LeaderXinjianSun/X758No2-PLC/微信图片_20170820083238.jpg

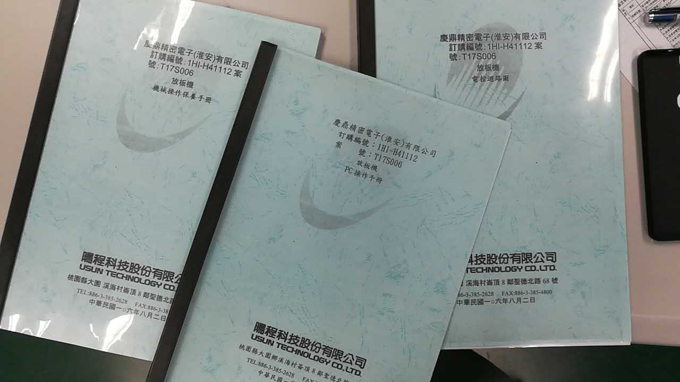
微信图片_20170820083238.jpg
