LeaderXinjianSun/X758No2-PLC/X758样本程序设计.docx

1. SamPickfromPanel 从样本盘取料
  a) 点位SampleP1、SampleP2、SampleP3、SampleP4和SamplePass1、SamplePass2
  b) 条件： 有需求（存在空穴）、爪手A、B都空
  c) 等待条件：→提示需要往样本盘添加产品
    i. 全空穴
  d) 备注：NGItems(PASS、NG1、NG2和NG3)在产品盘各占一个位置，最多4个
2. 爪手逻辑
  a) 有料
    i. 有需求→放料
    ii. 无需求→样本盘对应位置空→放回
    iii. 无需求→样本盘对应位置满→放入NG盘
  b) 无料
    i. 有需求→全空穴→退出。会在SamPickfromPanel函数里等待
    ii. 有需求→存在满穴→等测完，取出。但接收样本盘对应项目（有需求）有料打断
    iii. 无需求→存在满穴→等测完，取出
    iv. 无需求→全空穴→退出。会触发样本测试结束
3. Ngitems

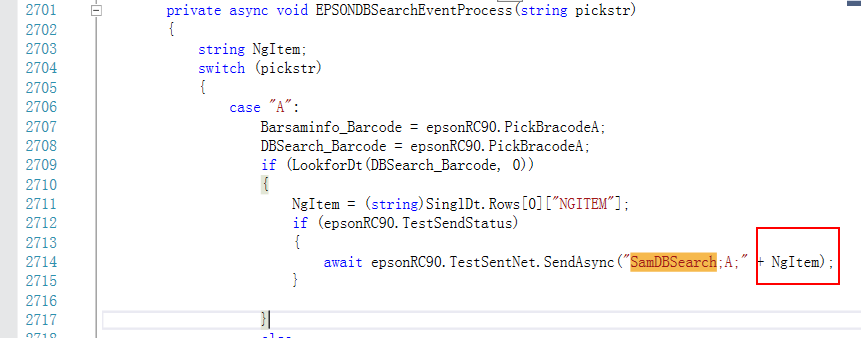
[picture p2: figure]
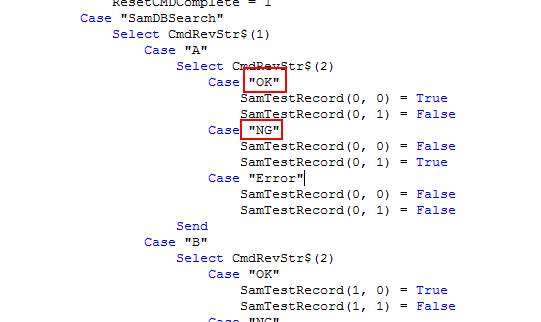
[picture p3: figure]
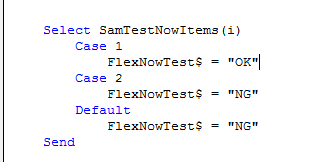
[picture p4: figure]
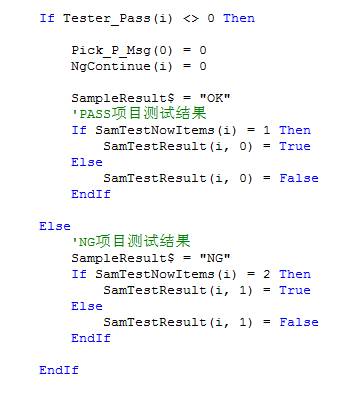
[picture p5: figure]

4. 待问询
  a) 何时有样本？
    i. 力德尔软体录入功能被取消，无法自行录入。
  b) 力德尔软体和上传软件通讯方式可否更改为网络通信？
    i. 采用UDP通讯
    ii. 此方式已在深圳Senser上料机实现
    iii. 客户计划的通信方式（DDE），
