LeaderXinjianSun/X758No2-PLC/力德尔技术手册封面.docx

# 鹏鼎控股(淮安)有限公司

## 订单编号：1HI-H31043

## 案号：T17S012

## 自动上料机

## 电控回路图

# 江苏力德尔电子信息技术有限公司

## JiangSu Leader Electronic Information Technology Co.，LTd

## 南通经济技术开发区新东路9号

## TEL: 86-513-65060557 FAX: 0513-65060559

## 二〇一七年六月二日
