LeaderXinjianSun/X758No2-PLC/X758GRR程序设计.docx

1. 从料盘取料
  a) 条件：
    i. A、B都空
    ii. 存在空穴
    iii. Pcs数不够
2. 爪手逻辑
  a) 有料：
    i. 测满→下料
    ii. 未侧满，空穴、目标穴→放料
  b) 无料
    i. 下一爪手有料，且存在空穴（打断）
    ii. 等测完，另外一只爪手有料，且当前穴是目标穴 或 当前穴次数未到
    iii. 等测完，另外一只爪手无料
      1. 拎
      2. 测试数未到→放（复测）
      3. 测试数到→不放
3. 下料逻辑
  a) 有料
    i. 测试次数到→下料
4. 测完判断
  a) 数量够、爪手无料、测试机全空
5. 初始有料
  a) 提示，要求清空
