LeaderXinjianSun/X758No2-PLC/X758资料.xlsx

Sheet: 设计规划
燕麦测试机线路归纳
测试机 | 3孔电源 |  |  | DB25接口
 | 2孔电源
 | 2孔电源
工控电脑 | 3孔电源 | 外网接口 | 内网接口
Mac电脑 | 2孔电源 | 外网接口 | 内网接口

Sheet: 采购20170210
序号 | 部件 | 型号 | 品牌 | 数量 | 备注 | 链接
1 | 开关面板 | 118型十孔 | 公牛 | 4 |  | https://detail.tmall.com/item.htm?id=19462920730&scene=taobao_shop
2 | 开关面板 | 118型十五孔 | 公牛 | 4 |  | https://detail.tmall.com/item.htm?id=15712582277&rn=fc19248c7d7d37fd1f3f4dd1f73d6402&abbucket=3
3 | 开关面板暗盒 | 118型十孔暗盒 | 公牛 | 4 |  | https://detail.tmall.com/item.htm?id=19464136209&scene=taobao_shop
4 | 开关面板暗盒 | 118型十五孔暗盒 | 公牛 | 4 |  | https://detail.tmall.com/item.htm?id=15716013019&scene=taobao_shop
5 | 4网口面板86型 | S2026C | 松日 | 4 |  | https://detail.tmall.com/item.htm?id=7596926201&ali_trackid=1_7183dcb1adca24f587821240ccff6bc4
6 | 松日86型暗盒 | 620105 | 松日 | 4 |  | https://detail.tmall.com/item.htm?_u=af5j4l7969a&id=7540695185
7 | 电脑主机 | 9020MT | 戴尔 | 1 |  | https://item.taobao.com/item.htm?spm=a1z10.1-c.w4004-1195050327.16.7s5mRP&id=45575396463
8 | PCI-E网卡 | EXPI9301C | Intel | 1 |  | https://item.jd.com/1529606972.html

Sheet: IO表
测试机抓放本体IO表(机械手)-RC90
序号 | 输入端子 | 线标 |  |  | 输出端子 | 线标 | 输出信号
1 | Input No.0 | IN0 | 负压表A |  | Output No.0 | OUT0 | 吸头A真空吸
2 | Input No.1 | IN1 | 负压表B |  | Output No.1 | OUT1 | 吸头A破真空
3 | Input No.2 | IN2 | 旋转气缸SET |  | Output No.2 | OUT2 | 吸头B真空吸
4 | Input No.3 | IN3 | 旋转气缸RST |  | Output No.3 | OUT3 | 吸头B破真空
5 | Input No.4 | IN4 | 测试机A-左 后到位信号 |  | Output No.4 | OUT4 | 旋转气缸
6 | Input No.5 | IN5 | 测试机A-右 后到位信号 |  | Output No.5 | OUT5 | 矫正气缸，上料
7 | Input No.6 | IN6 | 测试机A-左 上到位信号 |  | Output No.6 | OUT6 | 锤子气缸
8 | Input No.7 | IN7 | 测试机A-右 上到位信号 |  | Output No.7 | OUT7 | BR对位信号
9 | Input No.8 | IN8 | DangerIn |  | Output No.8 | OUT8 | 测试机A-左启动真空吸
10 | Input No.9 | IN9 | FeedReady |  | Output No.9 | OUT9 | 测试机A-右启动真空吸
11 | Input No.10 | IN10 | 测试机A-左穴1 真空吸状态信号 |  | Output No.10 | OUT10 | 测试机B-左启动真空吸
12 | Input No.11 | IN11 | 测试机A-左穴2 真空吸状态信号 |  | Output No.11 | OUT11 | 测试机B-右启动真空吸
13 | Input No.12 | IN12 | 测试机A-右穴1 真空吸状态信号 |  | Output No.12 | OUT12 | 吸头A上下气缸
14 | Input No.13 | IN13 | 测试机A-右穴2 真空吸状态信号 |  | Output No.13 | OUT13 | 吸头B上下气缸
15 | Input No.14 | IN14 | 测试机B-左 后到位信号 |  | Output No.14 | OUT14 | DangerOut
16 | Input No.15 | IN15 | 测试机B-右 后到位信号 |  | Output No.15 | OUT15 | FeedEmpty
17 | Input No.16 | IN16 | 测试机B-左 上到位信号
18 | Input No.17 | IN17 | 测试机B-右 上到位信号
19 | Input No.18 | IN18
20 | Input No.19 | IN19
21 | Input No.20 | IN20 | 测试机B- 左穴1 真空吸状态信号
22 | Input No.21 | IN21 | 测试机B-左穴2 真空吸状态信号
23 | Input No.22 | IN22 | 测试机B-右穴1 真空吸状态信号
24 | Input No.23 | IN23 | 测试机B -右穴2 真空吸状态信号
信捷PLC
序号 | 输入端子 | 线标 |  |  | 输出端子 | 线标 | 输出信号
1 | X0 | X0 | 安全门1 |  | Y0 | Y0 | 上料1电机脉冲 | XD5-60T6
2 | X1 | X1 | 安全门2 |  | Y1 | Y1 | 上料2电机脉冲
3 | X2 | X2 | 安全门3 |  | Y2 | Y2 | 下料1电机脉冲
4 | X3 | X3 | 安全门4 |  | Y3 | Y3 | 下料2电机脉冲
5 | X4 | X4 | 安全门5 |  | Y4 | Y4 | AL对位信号
6 | X5 | X5 | 安全门6 |  | Y5 | Y5 | AR对位信号
7 | X6 | X6 | 安全门7 |  | Y6 | Y6 | 上料1电机方向
8 | X7 | X7 | 安全门8 |  | Y7 | Y7 | 上料2电机方向
9 | X10 | X10 | 安全门9 |  | Y10 | Y10 | 下料1电机方向
10 | X11 | X11 | 安全门10 |  | Y11 | Y11 | 下料2电机方向
11 | X12 | X12 | 安全门11 |  | Y12 | Y12 | 屏蔽安全门
12 | X13 | X13 | 安全门12 |  | Y13 | Y13 | BL对位信号
13 | X14 | X14 | 急停按钮 |  | Y14 | Y14 | 三色灯-红
14 | X15 | X15 | 上料1模组上光电开关【常闭】 |  | Y15 | Y15 | 三色灯-黄
15 | X16 | X16 | 上料1模组下光电开关【常闭】 |  | Y16 | Y16 | 三色灯-绿
16 | X17 | X17 | 上料2模组上光电开关【常闭】 |  | Y17 | Y17 | 三色灯-蜂鸣器
17 | X20 | X20 | 上料2模组下光电开关【常闭】 |  | Y20 | Y20 | 无杆气缸，上料，产品
18 | X21 | X21 | 下料1模组上光电开关【常闭】 |  | Y21 | Y21 | 无杆气缸，上料，空盘
19 | X22 | X22 | 下料1模组下光电开关【常闭】 |  | Y22 | Y22 | 上下气缸，上料，产品
20 | X23 | X23 | 下料2模组上光电开关【常闭】 |  | Y23 | Y23 | 上下气缸，上料，空盘
21 | X24 | X24 | 下料2模组下光电开关【常闭】 |  | Y24 | Y24 | 真空吸，上料，空盘
22 | X25 | X25 | 按钮，上料电机1点动+ |  | Y25 | Y25 | DangerIn
23 | X26 | X26 | 按钮，上料电机1点动- |  | Y26 | Y26 | 真空吸1，上料，产品
24 | X27 | X27 | 按钮，上料电机1复位 |  | Y27 | Y27 | 真空吸2，上料，产品
25 | X30 | X30 | 按钮，上料电机2点动+
26 | X31 | X31 | 按钮，上料电机2点动-
27 | X32 | X32 | 按钮，上料电机2复位
28 | X33 | X33 | 无杆气缸，上料，产品，SET
29 | X34 | X34 | 料盘到位光纤，上料，产品盘2
30 | X35 | X35 | 无杆气缸，上料，产品，RST
31 | X36 | X36 | 无杆气缸，上料，空盘，SET
32 | X37 | X37 | 料盘到位光纤，上料，空盘2
33 | X40 | X40 | 无杆气缸，上料，空盘，RST
34 | X41 | X41 | 上下气缸，上料，产品，SET
35 | X42 | X42 | 上下气缸，上料，产品，RST
36 | X43 | X43 | 上下气缸，上料，空盘，SET
37 | X10000 | X10000 | 上下气缸，上料，空盘，RST |  | Y10000 | Y10000 | 真空吸3，上料，产品 | XD-E8X8YT
38 | X10001 | X10001 | 真空吸，上料，空盘，负压表 |  | Y10001 | Y10001 | 真空吸4，上料，产品
39 | X10002 | X10002 | 真空吸1，上料，产品，负压表 |  | Y10002 | Y10002 | 真空吸5，上料，产品
40 | X10003 | X10003 | 真空吸2，上料，产品，负压表 |  | Y10003 | Y10003 | 真空吸6，上料，产品
41 | X10004 | X10004 | 真空吸3，上料，产品，负压表 |  | Y10004 | Y10004 | 无杆气缸，下料，空盘
42 | X10005 | X10005 | 真空吸4，上料，产品，负压表 |  | Y10005 | Y10005 | 上下气缸，下料，空盘
43 | X10006 | X10006 | 真空吸5，上料，产品，负压表 |  | Y10006 | Y10006 | 真空吸，下料，空盘
44 | X10007 | X10007 | 真空吸6，上料，产品，负压表 |  | Y10007 | Y10007 | FeedReady
45 | X10100 | X10100 | 料盘有无光电开关，上料，产品盘 |  |  |  |  | XD-E16X
46 | X10101 | X10101 | 料盘有无光电开关，上料，空盘
47 | X10102 | X10102 | 料盘到位光纤，上料，产品盘
48 | X10103 | X10103 | 料盘到位光纤，上料，空盘
49 | X10104 | X10104 | 无杆气缸，下料，空盘，SET
50 | X10105 | X10105
51 | X10106 | X10106 | 无杆气缸，下料，空盘，RST
52 | X10107 | X10107 | 上下气缸，下料，空盘，SET
53 | X10110 | X10110 | 上下气缸，下料，空盘，RST
54 | X10111 | X10111 | 真空吸，下料，空盘，负压表
55 | X10112 | X10112 | 料盘有无光电开关，下料，产品盘
56 | X10113 | X10113 | 料盘有无光电开关，下料，空盘
57 | X10114 | X10114 | 料盘到位光纤，下料，产品盘
58 | X10115 | X10115 | 料盘到位光纤，下料，空盘
59 | X10116 | X10116 | 料盘到位光纤，下料，产品盘2
60 | X10117 | X10117 | 料盘到位光纤，下料，空盘2
61 | X10200 | X10200 | 按钮，下料电机1点动+ |  |  |  |  | XD-E16X
62 | X10201 | X10201 | 按钮，下料电机1点动-
63 | X10202 | X10202 | 按钮，下料电机1复位
64 | X10203 | X10203 | 按钮，下料电机2点动+
65 | X10204 | X10204 | 按钮，下料电机2点动-
66 | X10205 | X10205 | 按钮，下料电机2复位
67 | X10206 | X10206 | DangerOut
68 | X10207 | X10207 | FeedEmpty
69 | X10210 | X10210 | 上料吸盘光纤1
70 | X10211 | X10211 | 上料吸盘光纤2
71 | X10212 | X10212 | 下料吸盘光纤1
72 | X10213 | X10213 | 下料吸盘光纤2
73 | X10214 | X10214 | 无杆气缸，上料，空盘，MID
74 | X10215 | X10215
75 | X10216 | X10216
76 | X10217 | X10217
倍福PLC
序号 | 输入端子 | 线标 | 输入信号 | EL1889 | 输出端子 | 线标 | 输出信号 | EL2889
1 | Input No.1 | BFI1 | 机械手底座模组，原点 |  | Output No.1 | BFO1 | 上下气缸，下料，产品
2 | Input No.2 | BFI2 | 运料模组，原点 |  | Output No.2 | BFO2 | 真空吸，下料，产品
3 | Input No.3 | BFI3 | 下料X轴模组，原点 |  | Output No.3 | BFO3 | 真空吸，运料
4 | Input No.4 | BFI4 | 下料Y轴模组，原点 |  | Output No.4 | BFO4
5 | Input No.5 | BFI5 | 上下气缸，下料，产品，SET |  | Output No.5 | BFO5
6 | Input No.6 | BFI6 | 上下气缸，下料，产品，RST |  | Output No.6 | BFO6
7 | Input No.7 | BFI7 | 负压表，下料，产品 |  | Output No.7 | BFO7
8 | Input No.8 | BFI8 | 急停信号 |  | Output No.8 | BFO8
9 | Input No.9 | BFI9 | 安全门信号 |  | Output No.9 | BFO9
10 | Input No.10 | BFI10 |  |  | Output No.10 | BFO10
11 | Input No.11 | BFI11 |  |  | Output No.11 | BFO11
12 | Input No.12 | BFI12 |  |  | Output No.12 | BFO12
13 | Input No.13 | BFI13 |  |  | Output No.13 | BFO13
14 | Input No.14 | BFI14 |  |  | Output No.14 | BFO14
15 | Input No.15 | BFI15 |  |  | Output No.15 | BFO15
16 | Input No.16 | BFI16 |  |  | Output No.16 | BFO16

Sheet: 机柜布局
序号 | 部件 | 数量 | 宽度
1 | 8路继电器板 | 3 | 133
2 | 继电器 | 15 | 23
3 | 48V电源 | 1 | 110
4 | 24V电源 | 2 | 40
5 | 空开 | 6 | 35.4
6 | 漏电保护开关 | 1 | 63
7 | 单相滤波器 | 1 | 57.5 | https://item.taobao.com/item.htm?spm=a230r.1.14.1.siy64S&id=521259984914&ns=1&abbucket=15#detail
8 | DB25端子台 | 3 | 90
9 | DB50端子台 | 1 | 110
10 | 信捷60点PLC | 1 | 177.2
11 | 信捷8入8出模块 | 1 | 63
12 | 信捷16入模块 | 1 | 63
13 | 倍福 | 1 | 40
14 | 接地条 | 2
15 | 步进驱动器 | 4 |  | https://item.taobao.com/item.htm?id=39468895435&spm=2014.21600712.0.0
16 | 750W伺服驱动器 | 1
17 | 200W伺服驱动器 | 1
18 | 100W伺服驱动器 | 1
19 | 4连开关面板 | 1 |  | https://detail.tmall.com/item.htm?id=15712630333&rn=7c4cb6b3a5564bf28e34f05d51bb2908&abbucket=3
20 | 电脑 | 1
21 | 机械手控制器 | 1
22 | 7连大电磁阀 | 1
23 | 3连大电磁阀 | 1

Sheet: 物料清单 采购格式 (2)
 |  |  |  |  |  |  |  |  |  | 文件编号： | LDR-SJ-0220
物料清单（电气）: |  |  |  |  |  |  |  |  |  | 编号：
项目名称： |  | X758 FCT冶具自動上下料机 |  |  | 设计工程师： | 孙鑫建 |  |  | 制 单 时 间： |  | 20170323
客 户： |  | 臻鼎科技（淮安） |  |  | 领 料 人： |  |  |  | 装 配 时 间：
数 量： |  |  |  |  | 主 管 签 字： |  |  |  | 经 理 签 字：
序号 | 物料编号 | 物料名称 |  | 型号 |  | 品牌 | 数量 | 单位 | 单价 | 采购件 | 链接
1 |  | 控制 | 电脑主机 | 9020MT |  | 戴尔 | 1 | 台 |  | √ | https://item.taobao.com/item.htm?spm=a1z10.1-c.w4004-1195050327.16.7s5mRP&id=45575396463
2 |  |  | PCI-E网卡 | EXPI9301C |  | Intel | 1 | 个 |  | √
3 |  |  | PCI网卡 | TG-3269C |  | TP-LINK | 1 | 块
4 |  |  | PLC 主机 | XD5-60T4 |  | 信捷 | 1 | 个 |  | √
5 |  |  | PLC IO扩展 | XD-E8X8YT |  | 信捷 | 1 | 个 |  | √
6 |  |  | PLC IO扩展 | XD-E16X |  | 信捷 | 2 | 个 |  | √
7 |  |  | PLC 串口扩展 | XD-NE-BD |  | 信捷 | 1 | 个 |  | √
8 |  |  | PLC 耦合模块 | EK1100 |  | 倍福 | 1 | 个
9 |  |  | PLC 输入模块 | EL1889 |  | 倍福 | 1 | 个
10 |  |  | PLC 输出模块 | EL2889 |  | 倍福 | 1 | 个
11 |  |  | 交换机 | SF90D-16 |  | 思科 | 2 | 个 |  | √
12 |  |  | 触摸屏 | TH765-MT(P)/UT(P) |  | 信捷 | 1 | 个
13 |  |  | PLC数据线 | DVP 3m |  |  | 2 | 根
14 |  |  | 网线 | 2m |  |  | 3 | 根 |  | √
15 |  |  | 网线 | 0.5m |  |  | 3 | 根 |  | √
16 |  |  | 鼠标 | OP-520 |  | 双飞燕 | 1 | 个 |  | √
17 |  |  | 键盘 | KL-5 |  | 双飞燕 | 1 | 个 |  | √
18 |  |  | 扫码器 | SR700 |  | 基恩士 | 1 | 个 |  | √
19 |  |  | 显示器 | E1715S |  | 戴尔 | 1 | 个 |  | √
20 |  |  | 视频分割器 |  |  |  | 1 | 个 |  | √
21 |  |  | USB延长线 公对公 | 6m |  |  | 4 | 根 |  |  | https://detail.tmall.com/item.htm?id=18475491585&cm_id=140105335569ed55e27b&abbucket=15&skuId=3187969819168
22 |  |  | USB转RJ45网线接口 | 绿联20254 |  | 绿联 | 3 | 个 |  | √
23 |  |  | USB转485串口线 | UT-890 |  | 宇态 | 1 | 根
24 |  |  | 相机 | MER-500-14GM |  | 大恒相机 | 1 | 个 |  | √
25 |  |  | 镜头 | M0814-MP2 |  | Computar | 1 | 个 |  | √
26 |  | 电机 | 伺服电机 | ECMA-C20807RS |  | 台达 | 1 | 个 |  | √
27 |  |  | 伺服驱动器 | ASD-A2-0721-E |  | 台达 | 1 | 个 |  | √
28 |  |  | 伺服电机 | ECMA-C20602RS |  | 台达 | 2 | 个 |  | √
29 |  |  | 伺服驱动器 | ASD-A2-0221-E |  | 台达 | 2 | 个 |  | √
30 |  |  | 伺服电机 | ECMA-C20401ES |  | 台达 | 1 | 个 |  | √
31 |  |  | 伺服驱动器 | ASD-A2-0121-E |  | 台达 | 1 | 个 |  | √
32 |  |  | 电机动力线 | HVPS04AA03MB |  | 台达 | 4 | 根 |  | √
33 |  |  | 电机编码器线 | HVE13IAB03MB |  | 台达 | 4 | 根 |  | √
34 |  |  | 机械手 | LS3-401S |  | EPSON | 1 | 台 |  | √
35 |  |  | 机器人控制器 | RC90 |  | EPSON | 1 | 台 |  | √
36 |  |  | 步进电机 | 86HSZ12N |  | 普菲德 | 4 | 个 |  | √ | https://item.taobao.com/item.htm?id=39468895435&spm=2014.21600712.0.0
37 |  |  | 步进电机驱动器 | HBS86H |  | 普菲德 | 4 | 个 |  | √
38 |  | 电源 | 空气开关 | DZ47s-2P D10 |  | 德力西 | 6 | 个
39 |  |  | 漏电保护开关 | DZ47sLE C32 |  | 德力西 | 1 | 个
40 |  |  | 手柄+负荷开关 | VCF1C+V1C（32A） |  | 施耐德 | 1 | 个 |  | √
41 |  |  | 单相滤波器 | SJD430D-30A |  | 上海赛纪 | 1 | 个 |  | √
42 |  | 机柜 | 三色灯 | XVG-B3SM |  | 施耐德 | 1 | 个
43 |  |  | 风扇 | DLF1224LB |  |  | 6 | 个
44 |  |  | 按钮 | XB5AA31C NO |  | 施耐德 | 8 | 个
45 |  |  | 按钮 | XB5AA51C NO |  | 施耐德 | 4 | 个
46 |  |  | 急停按钮 | XB5AS542C 1NC |  | 施耐德 | 4 | 个
47 |  |  | 急停按钮黄色标牌 |  |  |  | 4 | 个
48 |  |  | 急停按钮保护罩 |  |  |  | 4 | 个
49 |  |  | 电源指示灯 | XB7EVM3LC |  | 施耐德 | 1 | 个
50 |  |  | 防暴LED灯 |  |  |  | 2 | 个
51 |  |  | 离子风机 | 545×430×69 |  |  | 3 | 个 |  | √
52 |  |  | 门开关 | FM18-08N |  |  | 12 | 个
53 |  |  | 继电器 | MY2N-GS |  |  | 15 | 个
54 |  |  | 环形变压器 | 400W 输入220V 输出50V |  | 普菲德 | 2 | 个 |  | √ | https://item.taobao.com/item.htm?id=40701634110&idnum=0
55 |  |  | 开关电源 | NDR-120-24 120W |  | 铭纬 | 2 | 个
56 |  |  | 传感器(方缸) | DS1-J |  | SMC | 4 | 个
57 |  |  | 传感器（无杆气缸） | GL-8H |  | SMC | 6 | 个
58 |  |  | 传感器（旋转气缸） | DMSH-020 |  | SMC | 2 | 个
59 |  |  | 传感器（下料上下） | CS1G020 |  | SMC | 2 | 个
60 |  |  | 光纤传感器 | FU-35 |  | 基恩士 | 8 | 个
61 |  |  | 光纤放大器 | FS-V21R |  | 基恩士 | 8 | 个
62 |  |  | 光电传感器 | E3ZG-D61 |  | 欧姆龙 | 4 | 个 |  | √
63 |  |  | 光电开关 | LU672-5NA |  | HUAYIFENG | 8 | 个 |  | √ | http://www.hyfcn.com/caoxingguangdianchuanganqi/40-30.html
64 |  |  | 转接板 | ST081N |  |  | 8 | 个
65 |  |  | DB50端子台 | 孔座 |  |  | 1 | 个 |  | √
66 |  |  | DB25端子台 | 孔座 |  |  | 1 | 个 |  | √
67 |  |  | DB50连接线 | 公对母3米 |  |  | 1 | 个 |  | √
68 |  |  | DB25连接线 | 公对母3米 |  |  | 1 | 个 |  | √
69 |  |  | DB25连接线 | 公对母8米 |  |  | 2 | 个 |  | √ | https://detail.tmall.com/item.htm?id=37296774762&cm_id=140105335569ed55e27b&abbucket=15&skuId=3244136704421
70 |  |  | DB9交叉线 | 母对母2米 |  |  | 1 | 个 |  | √
71 |  |  | DB25端子台 | 针座 |  |  | 2 | 个 |  | √
72 |  |  | 继电器板 | 8路/24V，低电平触发 |  | 欧姆龙 | 3 | 个 |  | √
73 |  |  | 开关面板 | 118型十孔 |  | 公牛 | 2 | 个 |  | √
74 |  |  | 开关面板 | 118型十五孔 |  | 公牛 | 3 | 个 |  | √
75 |  |  | 开关面板 | 118型二十孔 |  | 公牛 | 1 | 个 |  | √
76 |  |  | 开关面板暗盒 | 118型十孔暗盒 |  | 公牛 | 2 | 个 |  | √
77 |  |  | 开关面板暗盒 | 118型十五孔暗盒 |  | 公牛 | 2 | 个 |  | √
78 |  |  | 开关面板暗盒 | 118型二十孔暗盒 |  | 公牛 | 1 | 个 |  | √
79 |  |  | 开关面板86型 | 5孔 |  | 公牛 | 3 | 个 |  | √ | https://detail.tmall.com/item.htm?id=12602398346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
80 |  |  | 开关面板明盒86型 | 5孔明盒 |  | 公牛 | 3 | 个 |  | √ | https://detail.tmall.com/item.htm?spm=a1z10.3.w17-1900164721.12.x53eDv&id=7213752271
81 |  |  | 4网口面板86型 | S2026C |  | 松日 | 1 | 个 |  | √ | https://detail.tmall.com/item.htm?id=7596926201&ali_trackid=1_7183dcb1adca24f587821240ccff6bc4
82 |  |  | 松日86型暗盒 | 620105 |  | 松日 | 1 | 个 |  | √ | https://detail.tmall.com/item.htm?_u=af5j4l7969a&id=7540695185
83 |  |  | 静电插座 |  |  | 思米高 | 4 | 个 |  | √ | https://item.taobao.com/item.htm?spm=a230r.1.14.20.DcQKot&id=22969060230&ns=1&abbucket=15#detail
84 |  | 气动 | 电磁阀 | 4V210-08 7联 |  |  | 1 | 个
85 |  |  | 电磁阀 | 4V210-08 3联 |  |  | 1 | 个
86 |  |  | 电磁阀 | SY3120 6联 |  |  | 1 | 个
87 |  |  | 电磁阀 | SY3120 单个 |  |  | 5 | 个
88 |  |  | 多功能真空发生器 | ZK2A07K5KW-06 |  | SMC | 2 | 个
89 |  |  | 负压表 | DP-101 |  | 松下 | 9 | 个
90 |  | 装配 | 电源线 | 5m |  |  | 2 | 根
91 |  |  | 电源线 | 2m |  |  | 2 | 根
92 |  |  | VGA线 | 3m |  |  | 2 | 根 |  | √
93 |  |  | VGA线 | 6m |  |  | 4 | 根 |  | √ | https://detail.tmall.com/item.htm?id=44867041912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
94 |  |  | 接地柱 |  |  |  | 1 | 个
95 |  |  | 接地排 |  |  |  | 1 | 个
96 |  |  | 2.5mm 导线（黑色） |  |  |  |  | 米
97 |  |  | 2.5mm 导线 （蓝色） |  |  |  |  | 米
98 |  |  | 2.5mm 导线 （黄绿） |  |  |  |  | 米
99 |  |  | 1 mm 导线 （红色） |  |  |  |  | 米
100 |  |  | 1 mm 导线 （白色） |  |  |  |  | 米
101 |  |  | 0.5mm 导线 （黑色） |  |  |  |  | 米
102 |  |  | 多芯线 10芯 |  |  |  |  | 米
103 |  |  | 捷固端子 |  |  |  |  | 个
104 |  |  | 接地端子 |  |  |  |  | 个
105 |  |  | U型线鼻子 |  |  |  |  | 个
106 |  |  | 空中接头 |  |  |  |  | 个
107 |  |  | O型线鼻子 |  |  |  |  | 个
108 |  |  | 马鞍型固定座 |  |  |  |  | 个
109 |  |  | 导轨 |  |  |  |  | 米
110 |  |  | 线槽 |  |  |  |  | 米
111 |  |  | 插头 |  |  |  | 1 | 个

Sheet: 线束规划
电源线 | PC | 1
 | 显示器 | 2
 | 测试机 | 2
测试机 | 电源线 | 1
 | 网线 | 4
 | 地线 | 1
 | DB25 | 1
电源插头 | 交换机 | 2
 | 切屏器 | 1

Sheet: 多芯线
 | 序号 | 颜色 | 信号 | 信息
1 | 1 | 红 | 24V
 | 2 | 黑 | X25 | 按钮，上料电机1点动+
 | 3 | 棕 | X26 | 按钮，上料电机1点动-
 | 4 | 橙 | X27 | 按钮，上料电机1复位
 | 5 | 黄 | X30 | 按钮，上料电机2点动+
 | 6 | 绿 | X31 | 按钮，上料电机2点动-
 | 7 | 兰 | X32 | 按钮，上料电机2复位
 | 8 | 紫
 | 9 | 灰
 | 10 | 白 | 0V
 | 序号 | 颜色 | 信号 | 信息
2 | 1 | 红 | 24V
 | 2 | 黑 | X10200 | 按钮，下料电机1点动+
 | 3 | 棕 | X10201 | 按钮，下料电机1点动-
 | 4 | 橙 | X10202 | 按钮，下料电机1复位
 | 5 | 黄 | X10203 | 按钮，下料电机2点动+
 | 6 | 绿 | X10204 | 按钮，下料电机2点动-
 | 7 | 兰 | X10205 | 按钮，下料电机2复位
 | 8 | 紫
 | 9 | 灰
 | 10 | 白 | 0V
 | 序号 | 颜色 | 信号 | 信息
3 | 1 | 红 | 24V
 | 2 | 黑 | X15 | 上料1模组上光电开关
 | 3 | 棕 | X16 | 上料1模组下光电开关
 | 4 | 橙 | X10100 | 料盘有无光电开关，上料，产品盘
 | 5 | 黄 | X10102 | 料盘到位光纤，上料，产品盘
 | 6 | 绿 | X33 | 无杆气缸，上料，产品，SET
 | 7 | 兰 | X34 | 无杆气缸，上料，产品，MID
 | 8 | 紫 | X35 | 无杆气缸，上料，产品，RST
 | 9 | 灰
 | 10 | 白 | 0V
 | 序号 | 颜色 | 信号 | 信息
4 | 1 | 红 | 24V
 | 2 | 黑 | X0 | 安全门1
 | 3 | 棕 | X1 | 安全门2
 | 4 | 橙 | X2 | 安全门3
 | 5 | 黄 | X41 | 上下气缸，上料，产品，SET
 | 6 | 绿 | X42 | 上下气缸，上料，产品，RST
 | 7 | 兰
 | 8 | 紫
 | 9 | 灰
 | 10 | 白 | 0V
 | 序号 | 颜色 | 信号 | 信息
5 | 1 | 红 | 24V
 | 2 | 黑 | X17 | 上料2模组上光电开关
 | 3 | 棕 | X20 | 上料2模组下光电开关
 | 4 | 橙 | X10101 | 料盘有无光电开关，上料，空盘
 | 5 | 黄 | X10103 | 料盘到位光纤，上料，空盘
 | 6 | 绿 | X36 | 无杆气缸，上料，空盘，SET
 | 7 | 兰 | X37 | 无杆气缸，上料，空盘，MID
 | 8 | 紫 | X40 | 无杆气缸，上料，空盘，RST
 | 9 | 灰 | X10001 | 真空吸，上料，空盘，负压表
 | 10 | 白 | 0V
 | 序号 | 颜色 | 信号 | 信息
6 | 1 | 红 | 24V
 | 2 | 黑 | X3 | 安全门4
 | 3 | 棕 | X4 | 安全门5
 | 4 | 橙 | X5 | 安全门6
 | 5 | 黄 | X43 | 上下气缸，上料，空盘，SET
 | 6 | 绿 | X10000 | 上下气缸，上料，空盘，RST
 | 7 | 兰 | BFI2 | 运料模组，原点
 | 8 | 紫 | IN2 | 旋转气缸SET
 | 9 | 灰 | IN3 | 旋转气缸RST
 | 10 | 白 | 0V
 | 序号 | 颜色 | 信号 | 信息
7 | 1 | 红 | 24V
 | 2 | 黑 | X21 | 下料1模组上光电开关
 | 3 | 棕 | X22 | 下料1模组下光电开关
 | 4 | 橙 | X10112 | 料盘有无光电开关，下料，产品盘
 | 5 | 黄 | X10114 | 料盘到位光纤，下料，产品盘
 | 6 | 绿 | BFI5 | 上下气缸，下料，产品，SET
 | 7 | 兰 | BFI6 | 上下气缸，下料，产品，RST
 | 8 | 紫 | BFI3 | 下料X轴模组，原点
 | 9 | 灰 | BFI4 | 下料Y轴模组，原点
 | 10 | 白 | 0V
 | 序号 | 颜色 | 信号 | 信息
8 | 1 | 红 | 24V
 | 2 | 黑 | X11 | 安全门10
 | 3 | 棕 | X12 | 安全门11
 | 4 | 橙 | X13 | 安全门12
 | 5 | 黄 | BFI7 | 负压表，下料，产品
 | 6 | 绿 | BFO1 | 上下气缸，下料，产品
 | 7 | 兰 | BFO2 | 真空吸，下料，产品
 | 8 | 紫
 | 9 | 灰
 | 10 | 白 | 0V
 | 序号 | 颜色 | 信号 | 信息
9 | 1 | 红 | 24V
 | 2 | 黑 | X10104 | 无杆气缸，下料，空盘，SET
 | 3 | 棕 | X10105 | 无杆气缸，下料，空盘，MID
 | 4 | 橙 | X10106 | 无杆气缸，下料，空盘，RST
 | 5 | 黄 | X10107 | 上下气缸，下料，空盘，SET
 | 6 | 绿 | X10110 | 上下气缸，下料，空盘，RST
 | 7 | 兰 | X10111 | 真空吸，下料，空盘，负压表
 | 8 | 紫
 | 9 | 灰
 | 10 | 白 | 0V
 | 序号 | 颜色 | 信号 | 信息
10 | 1 | 红 | 24V
 | 2 | 黑 | X6 | 安全门7
 | 3 | 棕 | X7 | 安全门8
 | 4 | 橙 | X10 | 安全门9
 | 5 | 黄 | X17 | 上料2模组上光电开关
 | 6 | 绿 | X20 | 上料2模组下光电开关
 | 7 | 兰 | X10113 | 料盘有无光电开关，下料，空盘
 | 8 | 紫 | X10115 | 料盘到位光纤，下料，空盘
 | 9 | 灰
 | 10 | 白 | 0V
 | 序号 | 颜色 | 信号 | 信息
11 | 1 | 红 | 24V
 | 2 | 黑 | Y26 | 真空吸1，上料，产品
 | 3 | 棕 | Y27 | 真空吸2，上料，产品
 | 4 | 橙 | Y10000 | 真空吸3，上料，产品
 | 5 | 黄 | Y10001 | 真空吸4，上料，产品
 | 6 | 绿 | Y10002 | 真空吸5，上料，产品
 | 7 | 兰 | Y10003 | 真空吸6，上料，产品
 | 8 | 紫
 | 9 | 灰
 | 10 | 白 | 0V
 | 序号 | 颜色 | 信号 | 信息
12 | 1 | 红 | 24V
 | 2 | 黑 | X10002 | 真空吸1，上料，产品，负压表
 | 3 | 棕 | X10003 | 真空吸2，上料，产品，负压表
 | 4 | 橙 | X10004 | 真空吸3，上料，产品，负压表
 | 5 | 黄 | X10005 | 真空吸4，上料，产品，负压表
 | 6 | 绿 | X10006 | 真空吸5，上料，产品，负压表
 | 7 | 兰 | X10007 | 真空吸6，上料，产品，负压表
 | 8 | 紫
 | 9 | 灰
 | 10 | 白 | 0V
 | 序号 | 颜色 | 信号 | 信息
13 | 1 | 棕
 | 2 | 红 | A+
 | 3 | 品红 | A-
 | 4 | 黄 | B+
 | 5 | 绿 | B-
 | 6 | 兰
 | 序号 | 颜色 | 信号 | 信息
14 | 1 | 棕
 | 2 | 红 | A+
 | 3 | 品红 | A-
 | 4 | 黄 | B+
 | 5 | 绿 | B-
 | 6 | 兰
 | 序号 | 颜色 | 信号 | 信息
15 | 1 | 棕
 | 2 | 红 | A+
 | 3 | 品红 | A-
 | 4 | 黄 | B+
 | 5 | 绿 | B-
 | 6 | 兰
 | 序号 | 颜色 | 信号 | 信息
16 | 1 | 棕
 | 2 | 红 | A+
 | 3 | 品红 | A-
 | 4 | 黄 | B+
 | 5 | 绿 | B-
 | 6 | 兰
 | 序号 | 颜色 | 信号 | 信息
17 | 1 | 红 | 24V |  | 蓝1
 | 2 | 黑 | IN0 | 负压表A | 蓝2
 | 3 | 棕 | IN1 | 负压表B | 蓝3
 | 4 | 橙 | OUT0 | 吸头A真空吸 | 蓝4
 | 5 | 黄 | OUT1 | 吸头A破真空 | 蓝5
 | 6 | 绿 | OUT2 | 吸头B真空吸 | 棕1
 | 7 | 兰 | OUT3 | 吸头B破真空 | 棕2
 | 8 | 紫 | OUT12 | 吸头A上下气缸 | 棕3
 | 9 | 灰 | OUT13 | 吸头B上下气缸 | 棕4
 | 10 | 白 | 0V |  | 棕5
 | 序号 | 颜色
 | 1 | 红
 | 2 | 黑
 | 3 | 棕
 | 4 | 橙
 | 5 | 黄
 | 6 | 绿
 | 7 | 兰
 | 8 | 紫
 | 9 | 灰
 | 10 | 白

Sheet: DB端子台
 | 类型 | 板信息 | 序号 | 线标 | 功能 |  | 类型 | 板信息 | 序号 | 线标 | 功能 |  | 类型 | 板信息 | 序号 | 线标 | 功能
① | DB25 孔座 | 机械手安全回路 | 1 | ESW11 | 紧急停止SW1接点 | ③ | DB25 针座 | 燕麦测试机A | 1 | YM24V1 | 燕麦24V | ④ | DB25 针座 | 燕麦测试机B | 1 | YM24V2 | 燕麦24V
 |  |  | 2 | ESW12 | 紧急停止SW1接点 |  |  |  | 2 | ALUp | 左-天板上到位識別信號 |  |  |  | 2 | BLUp | 左-天板上到位識別信號
 |  |  | 3 | ESTOP1+ | 紧急停止通路1+ |  |  |  | 3 | ALRear | 左-天板后到位識別信號 |  |  |  | 3 | BLRear | 左-天板后到位識別信號
 |  |  | 4 | ESTOP1- | 紧急停止通路1- |  |  |  | 4 | ALRecify | 左-开始对位信号 |  |  |  | 4 | BLRecify | 左-开始对位信号
 |  |  | 5 |  |  |  |  |  | 5 | ARRecify | 右-开始对位信号 |  |  |  | 5 | BRRecify | 右-开始对位信号
 |  |  | 6 |  |  |  |  |  | 6 |  |  |  |  |  | 6
 |  |  | 7 | SD11 | 安全门输入1+ |  |  |  | 7 | ARUp | 右-天板上到位識別信號 |  |  |  | 7 | BRUp | 右-天板上到位識別信號
 |  |  | 8 | SD23 | 安全门输入1- |  |  |  | 8 | ARRear | 右-天板后到位識別信號 |  |  |  | 8 | BRRear | 右-天板后到位識別信號
 |  |  | 9 | C24V | RC90 24V输出 |  |  |  | 9 |  |  |  |  |  | 9
 |  |  | 10 | C24V | RC90 24V输出 |  |  |  | 10 |  |  |  |  |  | 10
 |  |  | 11 | C0V | RC90 24VGND输出 |  |  |  | 11 |  |  |  |  |  | 11
 |  |  | 12 | C0V | RC90 24VGND输出 |  |  |  | 12 |  |  |  |  |  | 12
 |  |  | 13 |  |  |  |  |  | 13 | ALSuck | 左-載板啟動真空吸 |  |  |  | 13 | BLSuck | 左-載板啟動真空吸
 |  |  | 14 | ESW21 | 紧急停止SW2接点 |  |  |  | 14 | ARSuck | 右-載板啟動真空吸 |  |  |  | 14 | BRSuck | 右-載板啟動真空吸
 |  |  | 15 | ESW22 | 紧急停止SW2接点 |  |  |  | 15 | ALPass | 左-PASS信號 |  |  |  | 15 | BLPass | 左-PASS信號
 |  |  | 16 | ESTOP2+ | 紧急停止通路2+ |  |  |  | 16 | ARPass | 右-PASS信號 |  |  |  | 16 | BRPass | 右-PASS信號
 |  |  | 17 | ESTOP2- | 紧急停止通路2- |  |  |  | 17 | ALVoccum1 | 左側穴1真空吸狀態信號 |  |  |  | 17 | BLVoccum1 | 左側穴1真空吸狀態信號
 |  |  | 18 | SDLATCH1 | 安全门闩锁解除 |  |  |  | 18 | ALVoccum2 | 左側穴2真空吸狀態信號 |  |  |  | 18 | BLVoccum2 | 左側穴2真空吸狀態信號
 |  |  | 19 | SDLATCH2 | 安全门闩锁解除 |  |  |  | 19 | ARVoccum1 | 右側穴1真空吸狀態信號 |  |  |  | 19 | BRVoccum1 | 右側穴1真空吸狀態信號
 |  |  | 20 | SD21 | 安全门输入2+ |  |  |  | 20 | ARVoccum2 | 右側穴2真空吸狀態信號 |  |  |  | 20 | BRVoccum2 | 右側穴2真空吸狀態信號
 |  |  | 21 | SD22 | 安全门输入2- |  |  |  | 21 | ALRun | 左-測試運行中 |  |  |  | 21 | BLRun | 左-測試運行中
 |  |  | 22 |  |  |  |  |  | 22 | ARRun | 右-測試運行中 |  |  |  | 22 | BRRun | 右-測試運行中
 |  |  | 23 |  |  |  |  |  | 23 |  |  |  |  |  | 23
 |  |  | 24 |  |  |  |  |  | 24 |  |  |  |  |  | 24
 |  |  | 25 |  |  |  |  |  | 25 | YM0V1 | 燕麦24VGND |  |  |  | 25 | YM0V2 | 燕麦24VGND
 | 类型 | 板信息 | 序号 | 线标 | 功能
② | DB50 孔座 | 机械手IO | 1 | COM | 输入公共端子No.0~7
 |  |  | 2 | IN0 | 输入No.0
 |  |  | 3 | IN1 | 输入No.1
 |  |  | 4 | IN2 | 输入No.2
 |  |  | 5 | IN3 | 输入No.3
 |  |  | 6 | IN4 | 输入No.4
 |  |  | 7 | IN5 | 输入No.5
 |  |  | 8 | IN6 | 输入No.6
 |  |  | 9 | IN7 | 输入No.7
 |  |  | 10 | OUT0 | 输出No.0
 |  |  | 11 | OUT1 | 输出No.1
 |  |  | 12 | OUT2 | 输出No.2
 |  |  | 13 | OUT3 | 输出No.3
 |  |  | 14 | OUT4 | 输出No.4
 |  |  | 15 | OUT5 | 输出No.5
 |  |  | 16
 |  |  | 17 | COM0 | 输出公共端子No.0~7
 |  |  | 18 | COM | 输入公共端子No.8~15
 |  |  | 19 | IN8 | 输入No.8
 |  |  | 20 | IN9 | 输入No.9
 |  |  | 21 | IN10 | 输入No.10
 |  |  | 22 | IN11 | 输入No.11
 |  |  | 23 | IN12 | 输入No.12
 |  |  | 24 | IN13 | 输入No.13
 |  |  | 25 | IN14 | 输入No.14
 |  |  | 26 | IN15 | 输入No.15
 |  |  | 27 | OUT6 | 输出No.6
 |  |  | 28 | OUT7 | 输出No.7
 |  |  | 29 | OUT8 | 输出No.8
 |  |  | 30 | OUT9 | 输出No.9
 |  |  | 31 | OUT10 | 输出No.10
 |  |  | 32
 |  |  | 33 | COM1 | 输出公共端子No.8~15
 |  |  | 34 | COM | 输入公共端子No.16~23
 |  |  | 35 | IN16 | 输入No.16
 |  |  | 36 | IN17 | 输入No.17
 |  |  | 37 | IN18 | 输入No.18
 |  |  | 38 | IN19 | 输入No.19
 |  |  | 39 | IN20 | 输入No.20
 |  |  | 40 | IN21 | 输入No.21
 |  |  | 41 | IN22 | 输入No.22
 |  |  | 42 | IN23 | 输入No.23
 |  |  | 43 | OUT11 | 输出No.11
 |  |  | 44 | OUT12 | 输出No.12
 |  |  | 45 | OUT13 | 输出No.13
 |  |  | 46 | OUT14 | 输出No.14
 |  |  | 47 | OUT15 | 输出No.15
 |  |  | 48
 |  |  | 49
 |  |  | 50

Sheet: 编程规划
 | 起始 | 结束
电机驱动 | M0 | M24 | 上料轴1
 | D0 | D24
 | HD0 | HD24
 | M25 | M49 | 上料轴2
 | D25 | D49
 | HD25 | HD49
 | M50 | M74 | 下料轴1
 | D50 | D74
 | HD50 | HD74
 | M75 | M99 | 下料轴2
 | D75 | D99
 | HD75 | HD99
全局监控 | M100 | M124
复位 | M125 | M174
标志位 | M175 | M199
逻辑步1 | M200 | M299
上料轴1 | M300 | M349
上料轴2 | M350 | M399
上位机通信 | M400 | M499
等待上料轴1，动作结束 | M500 | M524
等待上料轴2，动作结束 | M525 | M549
逻辑步1 | M600 | M699
上料轴1 | M700 | M749
上料轴2 | M750 | M799
等待下料轴1，动作结束 | M800 | M824
等待下料轴2，动作结束 | M825 | M849
调试2 | M850 | M899
逻辑步2 | M900 | M999
复位2 | M1000 | M1049
与机械手通信【读】 | D1000 | D1003
与机械手通信【写】 | D1006 | D1009
 | M1200 | M1299
 |  |  |  |  |  | 上料，轴1 | 上料，轴2
 |  |  |  | 动作 | 条件
 |  |  |  | 往上 |  | Up传感器/判断有无光电开关→降到底，报警（料盘空）→等待条件满足+“复位”
 |  |  |  |  | 光纤传感器【到】
 |  |  |  | 往下 |  |  | Down传感器→报警（空盘满）→等待条件满足+“复位”
 |  |  |  |  | 光纤传感器【无】

Sheet: 电机参数
步进电机 | 导程 | 5 | mm
 | 编码器分辨率 | 5000 | pls/rev
 | 齿轮比 | 1
 | 最高频率 | 50 | KHz
伺服电机 | 导程 | 16 | mm
 | 编码器分辨率 | 10000 | pls/rev
 | 刻度 | 0.0016
 | 最高速度 | 800 | mm/s
伺服电机 | 导程 | 20 | mm
 | 编码器分辨率 | 10000 | pls/rev
 | 刻度 | 0.002
 | 最高速度 | 1000 | mm/s

Sheet: 随机配送清单
X758随机配送清单 |  | 日期 | 20170308
序号 | 内容 | 数量 | 单位
1 | 电脑主机 | 1 | 台
2 | 显示器 | 1 | 个
3 | 鼠标 | 1 | 个
4 | 键盘 | 1 | 个
5 | 键盘支架 | 2 | 个
6 | 网线 | 2 | 根
7 | 急停按钮 | 4 | 套
8 | 静电环装置 | 4 | 个
9 | 机械手控制器 | 1 | 台
10 | USB延长线 | 1 | 根

Sheet: 调试计划
X758 NO.2 调试计划
序号 | 内容 | 时间
1 | 轴、气缸驱动程序验证 |  | 2017-03-10
2 | 机械手程序验证 | 2017-03-11 | 2017-03-12
3 | 上位机程序验证 | 2017-03-13 | 2017-03-14

Sheet: 补物料
部件 | 规格 | 数量 | 单位
USB延长线 | 公对公6米 | 4 | 根
DB25连接线 | 公对母8米 | 2 | 个
DB9交叉线 | 母对母2米 | 1 | 个
VGA线 | 6米 | 4 | 根
纽扣电池 | CR2032 | 1 | 个

Sheet: 机械手PLC通信
 | 机械手输入 | PLC |  | 机械手输出
1 | 512 | M2000 | DangerIn | 512 | M2100 | DangerOut
2 | 513 | M2001 |  | 513 | M2101
3 | 514 | M2002 |  | 514 | M2102 | FeedEmpty
4 | 515 | M2003 |  | 515 | M2103
5 | 516 | M2004 |  | 516 | M2104 | 旋转气缸SET
6 | 517 | M2005 |  | 517 | M2105 | 旋转气缸RST
7 | 518 | M2006 |  | 518 | M2106
8 | 519 | M2007 |  | 519 | M2107
9 | 520 | M2008 |  | 520 | M2108 | Discharing
10 | 521 | M2009 |  | 521 | M2109
11 | 522 | M2010 | CloseCMD | 522 | M2110 | PrePickCMD
12 | 523 | M2011 | AutoDischarge | 523 | M2111
13 | 524 | M2012 | FeedReady | 524 | M2112
14 | 525 | M2013 |  | 525 | M2113 | WaitPCS
15 | 526 | M2014 |  | 526 | M2114
16 | 527 | M2015 |  | 527 | M2115
17 | 528 | M2016 |  | 528 | M2116 | 暂停
18 | 529 | M2017 |  | 529 | M2117 | 运行
19 | 530 | M2018 |  | 530 | M2118
20 | 531 | M2019 |  | 531 | M2119
21 | 532 | M2020 |  | 532 | M2120
22 | 533 | M2021 |  | 533 | M2121
23 | 534 | M2022 |  | 534 | M2122
24 | 535 | M2023 | PreFill1 | 535 | M2123 | AL对位信号
25 | 536 | M2024 | PreFill2 | 536 | M2124 | AR对位信号
26 | 537 | M2025 | PreFill3 | 537 | M2125 | BL对位信号
27 | 538 | M2026 | PreFill4 | 538 | M2126
28 | 539 | M2027 | PreFill5 | 539 | M2127
29 | 540 | M2028 | PreFill6 | 540 | M2128
30 | 541 | M2029 |  | 541 | M2129
31 | 542 | M2030 |  | 542 | M2130 | Alarm_SuckFail
32 | 543 | M2031 |  | 543 | M2131 | Alarm_ReleaseFail
33 | 544 | M2032 |  | 544 | M2132
34 | 545 | M2033 |  | 545 | M2133
35 | 546 | M2034 |  | 546 | M2134
36 | 547 | M2035 |  | 547 | M2135
37 | 548 | M2036 |  | 548 | M2136
38 | 549 | M2037 |  | 549 | M2137
39 | 550 | M2038 |  | 550 | M2138
40 | 551 | M2039 |  | 551 | M2139
41 | 552 | M2040 |  | 552 | M2140
42 | 553 | M2041 |  | 553 | M2141
43 | 554 | M2042 |  | 554 | M2142
44 | 555 | M2043 |  | 555 | M2143
45 | 556 | M2044 |  | 556 | M2144
46 | 557 | M2045 |  | 557 | M2145
47 | 558 | M2046 |  | 558 | M2146
48 | 559 | M2047 |  | 559 | M2147
49 | 560 | M2048 |  | 560 | M2148
50 | 561 | M2049 |  | 561 | M2149
51 | 562 | M2050 |  | 562 | M2150
52 | 563 | M2051 |  | 563 | M2151
53 | 564 | M2052 |  | 564 | M2152
54 | 565 | M2053 |  | 565 | M2153
55 | 566 | M2054 |  | 566 | M2154
56 | 567 | M2055 |  | 567 | M2155
57 | 568 | M2056 |  | 568 | M2156
58 | 569 | M2057 |  | 569 | M2157
59 | 570 | M2058 |  | 570 | M2158
60 | 571 | M2059 |  | 571 | M2159
61 | 572 | M2060 |  | 572 | M2160
62 | 573 | M2061 |  | 573 | M2161
63 | 574 | M2062 |  | 574 | M2162
64 | 575 | M2063 |  | 575 | M2163

Sheet: 机械手命令
 |  | 底座位
取料位 | 进 | 上料盘 | pass ScanPositionP3L;go APickFeed1
 | 出 |  | pass ScanPositionP3L ;go ChangeHandL
治具穴1位 | 进 | 穴1 | PASS A1PASS1;PASS A1PASS2;PASS B_1 +z(5);GO A_1
 | 出 |  | PASS B_1 +z(5);PASS A1PASS2;PASS A1PASS1;GO ChangeHandL
治具穴2位 | 进 | 穴2 | PASS A2PASS1;PASS A2PASS2;PASS B_2 +z(5);GO A_2 +z(2.5)
 | 出 |  | PASS B_2;PASS A2PASS2;PASS A2PASS1;GO ChangeHandL
治具穴3位 | 进 | 穴3 | PASS A3PASS1;PASS A3PASS2;PASS B_3 +z(5);GO A_3
 | 出 |  | PASS B_3 +z(5);PASS A3PASS2;PASS A3PASS1;GO ChangeHandL
治具穴4位 | 进 | 穴4 | PASS A4PASS1;PASS A4PASS2;PASS A4PASS3;PASS A4PASS4;PASS B_4 + z(5);GO A_4
 | 出 |  | pass b_4 +z(5);PASS A4PASS4;PASS A4PASS3;PASS A4PASS2;PASS A4PASS1;GO ChangeHandL
NG位 | 进 | NG盘 | pass NCuip1;pass NCuip2;pass NCuip3;go NCui_1
 | 出 |  | pass NCuip3;pass NCuip2;pass NCuip1;go ChangeHandL
样本盘 | 进 | 样本盘 | pass SamplePass1;pass SamplePass2;go SampleP1_A
 | 出 |  | pass SamplePass2;pass SamplePass1;go ChangeHandL

Sheet: 机械手点位说明
点 | 标签 | 底座 | 机械手姿势 | 说明
P7 | ScanPositionP3L | 上料位 | Left | 扫码坐标
P8 | ScanPositionP3L_B | 上料位 | Left | 扫码坐标B爪
P11 | APickFeed1 | 上料位 | Left | 矫正盘吸取位1
P12 | APickFeed2 | 上料位 | Left | 矫正盘吸取位2
P13 | APickFeed3 | 上料位 | Left | 矫正盘吸取位3
P14 | APickFeed4 | 上料位 | Left | 矫正盘吸取位4
P15 | APickFeed5 | 上料位 | Left | 矫正盘吸取位5
P16 | APickFeed6 | 上料位 | Left | 矫正盘吸取位6
P30 | TPosition1 | 穴1 | Left | B爪放下料小车位1
P31 | TPosition2 | 穴2 | Left | B爪放下料小车位2
P32 | TPosition3 | 穴3 | Left | B爪放下料小车位3
P33 | TPosition4 | 穴4 | Left | B爪放下料小车位4
P34 | TPosition1_A | 穴1 | Left | A爪放下料小车位1
P35 | TPosition2_A | 穴2 | Left | A爪放下料小车位2
P36 | TPosition3_A | 穴3 | Left | A爪放下料小车位3
P37 | TPosition4_A | 穴4 | Left | A爪放下料小车位4
P38 | TPosition5 | 上料位 | Left | B爪放下料小车位5
P39 | TPosition5_A | 上料位 | Left | A爪放下料小车位5
P41 | A_1 | 穴1 | Left | A爪测试机内取放产品位1
P42 | A_2 | 穴2 | Left | A爪测试机内取放产品位2
P43 | A_3 | 穴3 | Left | A爪测试机内取放产品位3
P44 | A_4 | 穴4 | Left | A爪测试机内取放产品位4
P51 | B_1 | 穴1 | Left | B爪测试机内取放产品位1
P52 | B_2 | 穴2 | Left | B爪测试机内取放产品位2
P53 | B_3 | 穴3 | Left | B爪测试机内取放产品位3
P54 | B_4 | 穴4 | Left | B爪测试机内取放产品位4
P80 | ChangeHandL |  | Left | 机械手收缩姿势
P120 | SampleP1 | 样本盘 | Left | B爪手样本盘点1
P121 | SampleP2 | 样本盘 | Left | B爪手样本盘点2
P122 | SampleP3 | 样本盘 | Left | B爪手样本盘点3
P123 | SampleP4 | 样本盘 | Left | B爪手样本盘点4
P124 | SampleP5 | 样本盘 | Left | B爪手样本盘点5
P125 | SampleP6 | 样本盘 | Left | B爪手样本盘点6
P126 | SampleP7 | 样本盘 | Left | B爪手样本盘点7
P127 | SampleP8 | 样本盘 | Left | B爪手样本盘点8
P128 | SampleP1_A | 样本盘 | Left | A爪手样本盘点1
P129 | SampleP2_A | 样本盘 | Left | A爪手样本盘点2
P130 | SampleP3_A | 样本盘 | Left | A爪手样本盘点3
P131 | SampleP4_A | 样本盘 | Left | A爪手样本盘点4
P132 | SampleP5_A | 样本盘 | Left | A爪手样本盘点5
P133 | SampleP6_A | 样本盘 | Left | A爪手样本盘点6
P134 | SampleP7_A | 样本盘 | Left | A爪手样本盘点7
P135 | SampleP8_A | 样本盘 | Left | A爪手样本盘点8
P140 | SamplePass1 | 样本盘 | Left | 去样本盘经过点1
P141 | SamplePass2 | 样本盘 | Left | 去样本盘经过点2
P220 | A1PASS1 | 穴1 | Left | 去穴1经过点1
P221 | A1PASS2 | 穴1 | Left | 去穴1经过点2
P230 | A2PASS1 | 穴2 | Left | 去穴2经过点1
P231 | A2PASS2 | 穴2 | Left | 去穴2经过点2
P240 | A3PASS1 | 穴3 | Left | 去穴3经过点1
P241 | A3PASS2 | 穴3 | Left | 去穴3经过点2
P250 | A4PASS1 | 穴4 | Left | 去穴4经过点1
P251 | A4PASS2 | 穴4 | Left | 去穴4经过点2
P252 | A4PASS3 | 穴4 | Left | 去穴4经过点3
P253 | A4PASS4 | 穴4 | Left | 去穴4经过点4
P104 | NCui_1 | NG盘 | Right | B爪放NG盘矩阵点1
P105 | NCui_2 | NG盘 | Right | B爪放NG盘矩阵点2
P106 | NCui_3 | NG盘 | Right | B爪放NG盘矩阵点3
P440 | NCui_1_A | NG盘 | Right | A爪放NG盘矩阵点1
P441 | NCui_2_A | NG盘 | Right | A爪放NG盘矩阵点2
P442 | NCui_3_A | NG盘 | Right | A爪放NG盘矩阵点3
P290 | NCuip1 | NG盘 | Left | 去NG盘经过点1
P291 | NCuip2 | NG盘 | Right | 去NG盘经过点2
P292 | NCuip3 | NG盘 | Right | 去NG盘经过点3
P460 | NoiseCui_1 | Noise盘 | Right | B爪放Noise盘矩阵点1
P461 | NoiseCui_2 | Noise盘 | Right | B爪放Noise盘矩阵点2
P462 | NoiseCui_3 | Noise盘 | Right | B爪放Noise盘矩阵点3
P463 | NoiseCui_1_A | Noise盘 | Right | A爪放Noise盘矩阵点1
P464 | NoiseCui_2_A | Noise盘 | Right | A爪放Noise盘矩阵点2
P465 | NoiseCui_3_A | Noise盘 | Right | A爪放Noise盘矩阵点3

Sheet: 机械手IO说明
序号 | 输入端子 | 机械手标签 |  | 输出端子 |  | 输出信号
1 | Input No.0 | VacuumValueA | 负压表A | Output No.0 | SuckA | 吸头A真空吸
2 | Input No.1 | VacuumValueB | 负压表B | Output No.1 | BlowA | 吸头A破真空
3 | Input No.2 | RollSet | 旋转气缸SET | Output No.2 | SuckB | 吸头B真空吸
4 | Input No.3 | RollReset | 旋转气缸RST | Output No.3 | BlowB | 吸头B破真空
5 | Input No.4 | ALRear | 测试机A-左 后到位信号 | Output No.4 | RollValve | 旋转气缸
6 | Input No.5 | ARRear | 测试机A-右 后到位信号 | Output No.5 | AdjustValve | 矫正气缸，上料
7 | Input No.6 | ALUp | 测试机A-左 上到位信号 | Output No.6 | ChuiZi | 锤子气缸
8 | Input No.7 | ARUp | 测试机A-右 上到位信号 | Output No.7
9 | Input No.8 | DangerIn | DangerIn | Output No.8 | AL_Suck | 测试机A-左启动真空吸
10 | Input No.9 | FeedReady | FeedReady | Output No.9 | AR_Suck | 测试机A-右启动真空吸
11 | Input No.10 | ALVacuumValue1 | 测试机A-左穴1 真空吸状态信号 | Output No.10 | BL_Suck | 测试机B-左启动真空吸
12 | Input No.11 | ALVacuumValue2 | 测试机A-左穴2 真空吸状态信号 | Output No.11 | BR_Suck | 测试机B-右启动真空吸
13 | Input No.12 | ARVacuumValue1 | 测试机A-右穴1 真空吸状态信号 | Output No.12 | ValveA | 吸头A上下气缸
14 | Input No.13 | ARVacuumValue2 | 测试机A-右穴2 真空吸状态信号 | Output No.13 | ValveB | 吸头B上下气缸
15 | Input No.14 | BLRear | 测试机B-左 后到位信号 | Output No.14 | DangerOut | DangerOut
16 | Input No.15 | BRRear | 测试机B-右 后到位信号 | Output No.15 | FeedEmpty | FeedEmpty
17 | Input No.16 | BLUp | 测试机B-左 上到位信号
18 | Input No.17 | BRUp | 测试机B-右 上到位信号
19 | Input No.18
20 | Input No.19
21 | Input No.20 | BLVacuumValue1 | 测试机B- 左穴1 真空吸状态信号
22 | Input No.21 | BLVacuumValue2 | 测试机B-左穴2 真空吸状态信号
23 | Input No.22 | BRVacuumValue1 | 测试机B-右穴1 真空吸状态信号
24 | Input No.23 | BRVacuumValue2 | 测试机B -右穴2 真空吸状态信号

Sheet: 网络IP规划
 | 主机 |  |  |  | 网络相机 | 机械手控制器 | Mini主机A |  | Mini主机B
 | 网卡1（主板自带） | 网卡2（PCI-E） | 网卡3（PCI） | 网卡3（USB） | GigE相机 | RC90控制器 | 网卡1（本体） | 网卡2（USB） | 网卡1（本体） | 网卡2（USB）
内网 | 192.168.10.100 |  |  |  |  | 192.168.10.10 | 192.168.10.50 |  | 192.168.10.51
外网 |  |  |  | 自动 |  |  |  | 自动 |  | 自动
直连 |  |  | 192.168.11.111 |  | 192.168.11.112

Sheet: 样本程序设计
发送 | 接收
SamSearchflag = 0 CmdSend$ = "SamDBSearch,A"
 |  |  |  |  | 料号 | PARTNUM
 |  |  |  |  | 测试项目 | SITEM
 |  |  |  |  | 条码 | BARCODE
 |  |  |  |  | 测试项目 | NGITEM
 |  |  |  |  | 测试结果 | TRES
 |  |  |  |  | 测试机台 | MNO
 |  |  |  |  | 测试日期 | CDATE
 |  |  |  |  | 测试时间 | CTIME
 |  |  |  |  |  | barsamuser_uno
 |  |  |  |  |  | barsamuser_psw
 |  |  | 料号 | barsaminfopartnum
 |  |  | 条码 | barsaminfobarcode
 |  |  | 不良项目 | barsaminfongitem
 |  |  | 样本使用次数 | barsaminfostnum
 |  |  | 已使用次数 | barsaminfounum
 |  | SampleResult,1,OK,OK
 |  |  | order by testdate desc, testtime desc
 |  |  |  |  |  | X758FlexOpened
select * from fluke_data where barcode = 'G5Y7163B01SHP1953ZM5' AND TESTDATE = '20170420' ORDER BY TESTTIME DESC

Sheet: 条码保存设计
E:/barcode/20170420/Scan20170420
E:/barcode/20170420/Hole120170420
E:/barcode/20170420/Hole220170420
E:/barcode/20170420/Hole320170420
E:/barcode/20170420/Hole420170420

Sheet: 软件版本说明
日期 | 更新内容 | 程序文件 | 拷贝程序包
2017-04-21 | 1、提前合矫正气缸，合2次 2、上料盘不再送矫正气缸，吸取失败松开再吸取 3、抛料治具真空后打开；第1次抛料失败，断治具真空再压一下，持续1秒 4、吸取时间加长，吸取失败retry3次，每次时间增加0.3秒 | ·Epson ·PLC ·触摸屏 | 20170421X758in05.rar
2017-04-22 | 1、样本查询不良项目 | ·Epson ·上位机 | 20170422X758in02.rar
2017-04-24 | 1、修改抛料高度：2.5->4 2、修改从矫正盘吸取动作：第一次失败，松夹爪；第二次失败，不放真空，报警。 3、修改每日凌晨清空报警数据。 4、截取样本测试时，插入数据TRES项数据长度未20 | ·Epson ·上位机 | 20170424X758in02.rar
2017-04-25 | 1、修改报警清空时机为8:00和20:00 2、锤子气缸功能试验 | ·Epson ·上位机 | 20170425X758in01.rar
2017-04-25 | 1、修改吸取失败，排料导致撞机bug 2、延长吸取时间0.3->0.4 3、修改拍照处理置位气缸Y20，不受排料信号影响。 | ·Epson ·PLC | 20170425X758in03.rar
2017-04-27 | 1、判断上料盘是否有料，判断多pcs，节约时间。 2、上料盘吸取失败，需要将产品放好，再吸取原来位置。 3、将相机拍摄的信号反馈给机械手，而不是采用吸盘真空信号。 4、取消“Leader”Logo | ·Epson ·PLC ·上位机 | 20170427X758in01.rar
2017-04-27 | 1、提前打开扫码 2、上料空盘无杆气缸复位1.5秒，触发拍照 | ·Epson ·PLC | 20170427X758in03.rar
2017-04-28 | 1、上料盘取料，最后一片，吸盘提前拎起产品 2、治具内吸取失败，重复吸取，直至产品成功吸取。 | ·Epson ·PLC ·上位机 | 20170428X758in01.rar
2017-05-05 | 1、过8点生成报警记录 2、同位置重复报警不累计 3、吸取产品，Z轴后下降 4、抛料吸嘴不压到底 5、报警10秒，不再响 6、拍照提前 | ·Epson ·PLC ·上位机 | 20170505X758in01.rar

Sheet: X758项目交流表
X758项目交流表 |  |  |  | 日期 | 2017 年
 |  |  |  |  | 月 日
量产进度 | / 70 |  | 本批台数
公司-电气工程师
现场-电气工程师
公 司 事 项 | 事项 | 内容 |  |  |  | 责任人
现 场 事 项 | 事项 | 内容 |  |  |  | 责任人
