LeaderXinjianSun/X758No2-PLC/X758项目表格总汇.xlsx

Sheet: X758项目交流表
X758项目交流表 |  |  |  | 日期 | 2017 年
 |  |  |  |  | 月 日
量产进度 | / 70 |  | 本批台数
公司-电气工程师
现场-电气工程师
公 司 事 项 | 事项 | 内容 |  |  |  | 责任人
现 场 事 项 | 事项 | 内容 |  |  |  | 责任人

Sheet: X758项目现场状态表
X758项目机台状态表 |  |  |  | 日期 | 2017 年
 |  |  |  |  | 月 日
机台编号 | 状态 | 地点 | 备注
L1 | 运行中 | 臻鼎
L2 | 运行中 | 臻鼎
L3 | 运行中 | 臻鼎
L4 | 运行中 | 臻鼎
L5 | 运行中 | 臻鼎
L6 | 运行中 | 臻鼎
L7 | 运行中 | 臻鼎
L8 | 运行中 | 臻鼎
L9 | 运行中 | 臻鼎
L10 | 运行中 | 臻鼎
L11
L12
L13
L14
L15
L16
L17
L18
L19
L20
L21
L22
L23
L24
L25
L26
L27
L28
L29
L30
L31
L32
L33
L34
L35
L36
L37
L38
L39
L40
L41
L42
L43
L44
L45
L46
L47
L48
L49
L50
L51
L52
L53
L54
L55
L56
L57
L58
L59
L60
L61
L62
L63
L64
L65
L66
L67
L68
L69
L70
