LeaderXinjianSun/X758No2-PLC/(list of files, cad)

Other CAD files:
电路图/X758/01.dwg
电路图/X758/19.dwg
电路图/X758/07.dwg
电路图/X758/03.dwg
电路图/X758/13.dwg
电路图/X758/10.dwg
电路图/X758/11.dwg
电路图/X758/16.dwg
电路图/X758/12.dwg
电路图/X758/06.dwg
电路图/X758/18.dwg
电路图/X758/17.dwg
电路图/X758/15.dwg
电路图/X758/20.dwg
电路图/X758/02.dwg
电路图/X758/05.dwg
电路图/X758/14.dwg
电路图/X758/09.dwg
电路图/X758/08.dwg
电路图/X758/04.dwg
