LeaderXinjianSun/X758No2-PLC/X758上料机调试手册.docx

X758项目

调试手册

力德尔-电控

1. 准备
  a) 通气
  b) 通电
    i. 插电前，闭合所有空开，用万用表点检是否存在短路
      1. L、N、PE短路检查
      2. 24V、0V短路检查
      3. 检查各部件是否得电，工作正常
  c) 电脑环境配置
a. 32bit Win7系统（需激活）
b. 倍福Twincat软件（需激活）
c. XDPPro
d. TouchWin
e. .net4.0、.net4.5.2
f. halcon10（需激活）
g. 基恩士Auto_ID
h. 电机调试软件
2. 程序下载
  a) PLC
    i. 文件名称：X758NO2.xdp（PLC）
    ii. 文件名称：X758NO2.txp（触摸屏）
    iii. 第一次下载PLC程序，需要把配置参数，初始值一并下载。
  b) 机械手程序
    i. 项目程序：EpsonRC90forX758
    ii. 将项目文件夹复制到目录：C:\EpsonRC70\projects
    iii. USB连接到机械手，打开机械手软体
    iv. 选择USB连接机械手

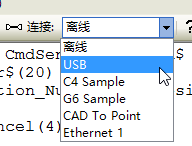
[picture p25: figure]

    v. 打开项目：项目——打开——project——EpsonRC90forX758——new1——x758_1
    vi. 编译、下载
    vii. 机械手控制器设置

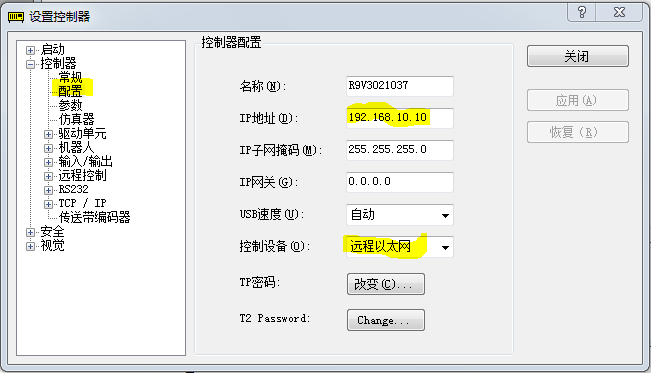
[picture p26: figure]
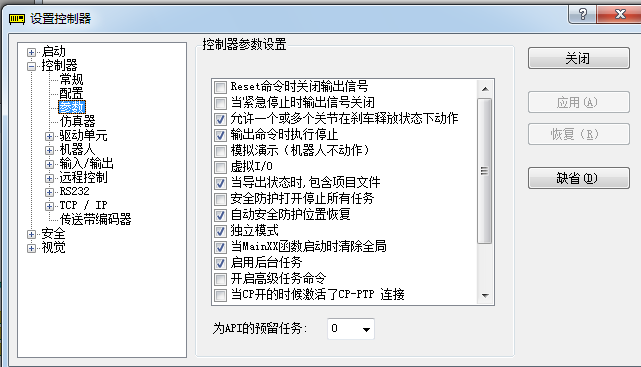
[picture p27: figure]
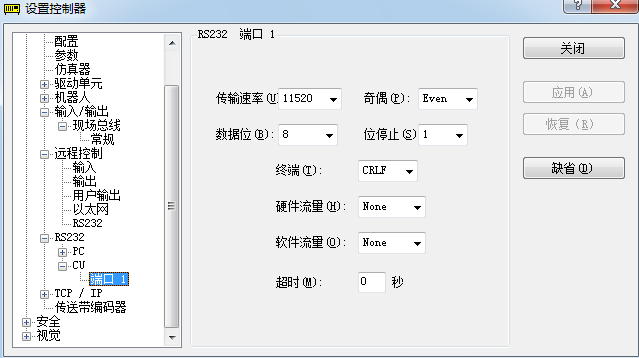
[picture p28: figure]
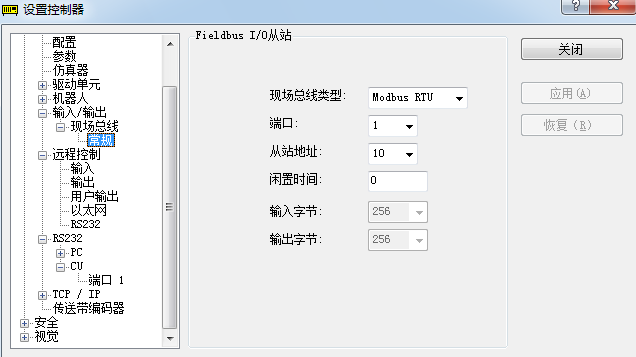
[picture p29: figure]
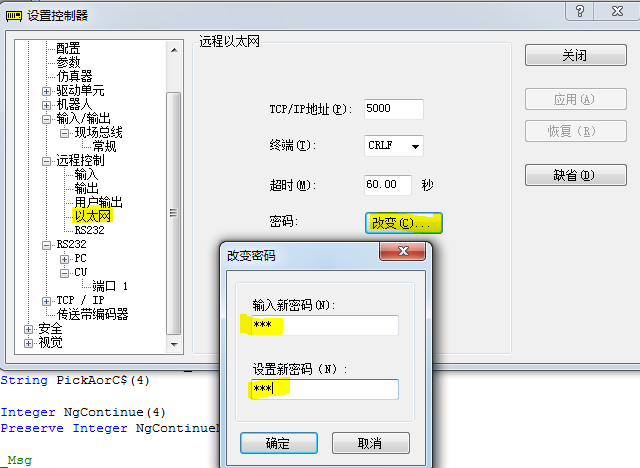
[picture p30: figure]
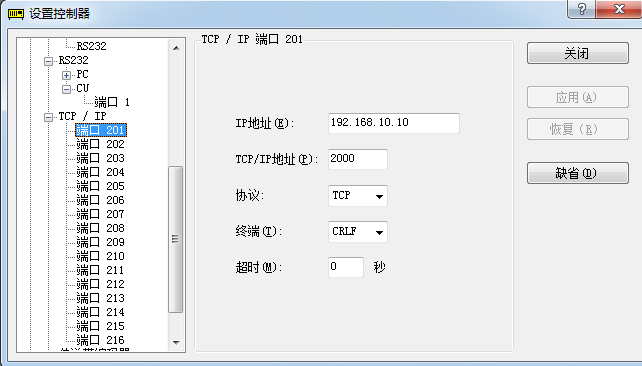
[picture p31: figure]

  c) 倍福程序
    i. 项目程序：X758BeckhoffPLC
    ii. TwinCAT软件 右键

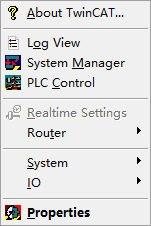
[picture p32: figure]

    iii. Properties设置
    iv. System Manager设置
      1. 新建
      2. 保存。保存到备份目录，命名为X758NO2_1.tsm

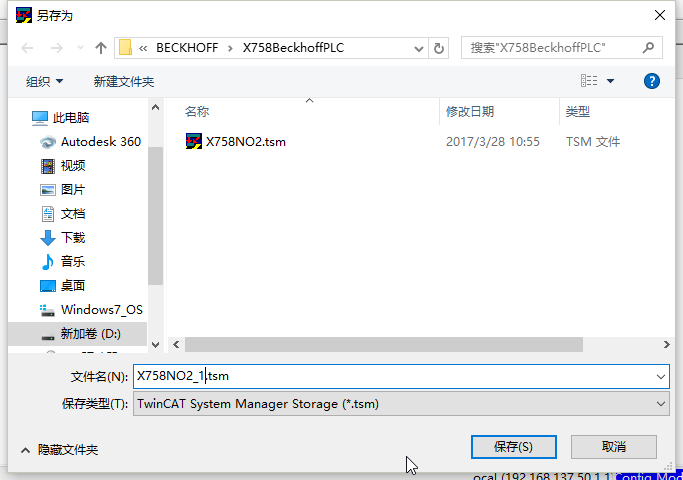
[picture p33: figure]
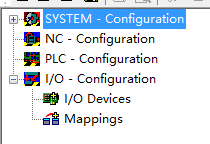
[picture p34: figure]

      4. SYSTEM-Configuration设置
        a) Auto Boot（启动模式）设置为Run Mode
          i. 用户名和密码跟随系统

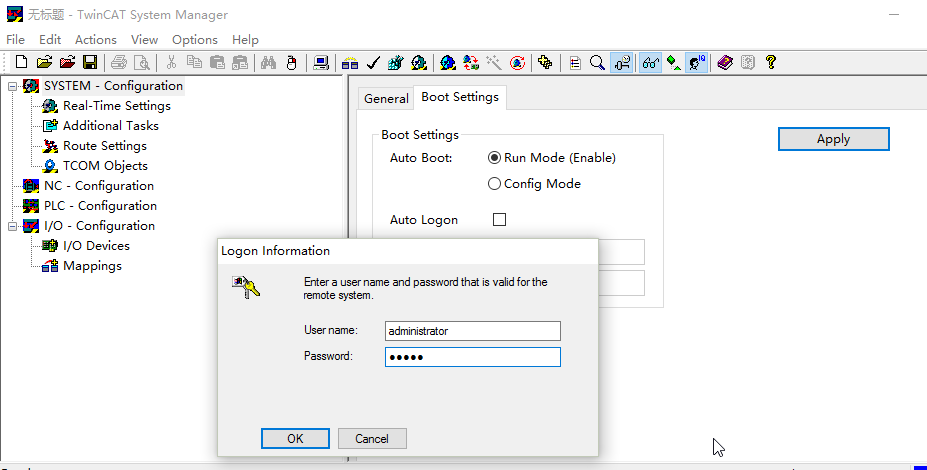
[picture p35: figure]

      5. I/O--Configuration设置
        a) 扫描Ethercat硬件

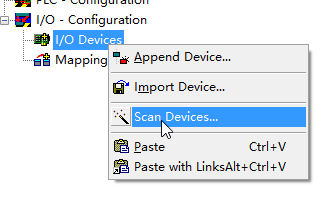
[picture p36: figure]

      6. NC—Configuration设置

轴参数

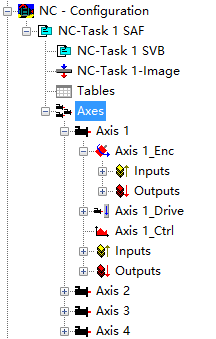
[picture p37: figure]

        a) 先设置编码器参数，再设置轴参数

编码器参数

        b) Axis?_Enc - Parameter 编码器参数设置
            1. 齿轮比：数值=导程÷编码器分辨率
            1. 回原点方向设置
            a) Calibration Cam Search：寻找原点方向
            b) Sync Impuls Search：离开原点方向
            2. FALSE：正方向运动
            3. 正方向：远离电机方向
            4. 寻参方式：Plc CAM
        c) 对于台达伺服电机，需要将电机和编码器方向取反
        d) Axis ? – Parameter轴参数设置

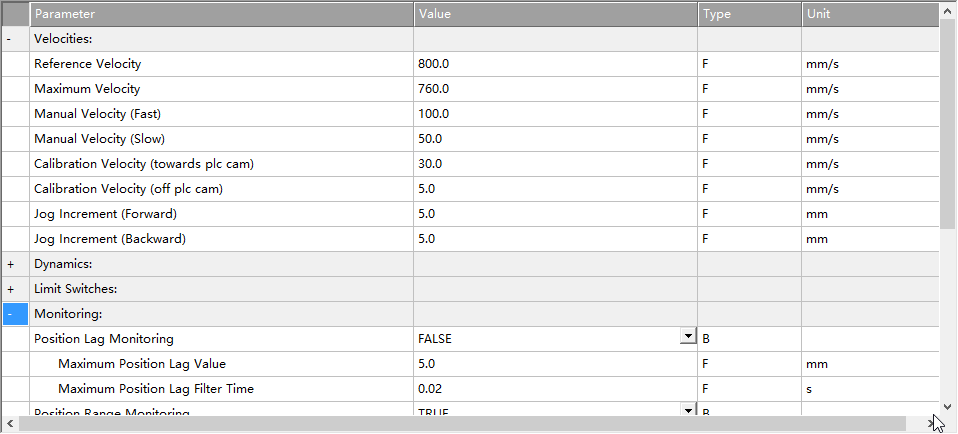
[picture p38: figure]
Parameter Velocities: Reference Velocity Maximum Velocity Manual Velocity (Fast) Manual Velocity (Slow) Calibration Velocity (towards plc cam) Calibration Velocity (off plc cam) Jog Increment (Forward) Jog Increment (Backward) + Dyna mics: + Limit Switches: Monitoring: Position Lag Monitoring Maxi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

          ii. Reference Velocity：最大速度
          iii. Maxmum Velocity：最大速度×95%
          iv. Manual Velocity(Fast):点动调试速度（快速）
          v. Manual Velocity(Slow):点动调试速度（慢速）
          vi. Calibration Velocity(towards plc cam):原点回归速度
          vii. Calibration Velocity(off plc cam):爬行速度
          viii. Position Lag Monitioring：FALSE 不监控
        e) Axis ? – Dynamics加减速参数设置

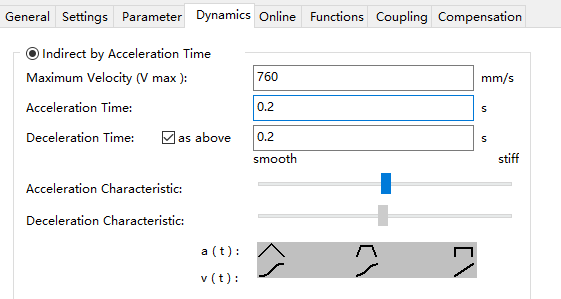
[picture p39: figure]

          ii. 设置加减速时间为0.2秒
      7. PLC—Configuration设置
        a) 选择PLC程序文件：X758PLC.tpy
        b) 连接变量

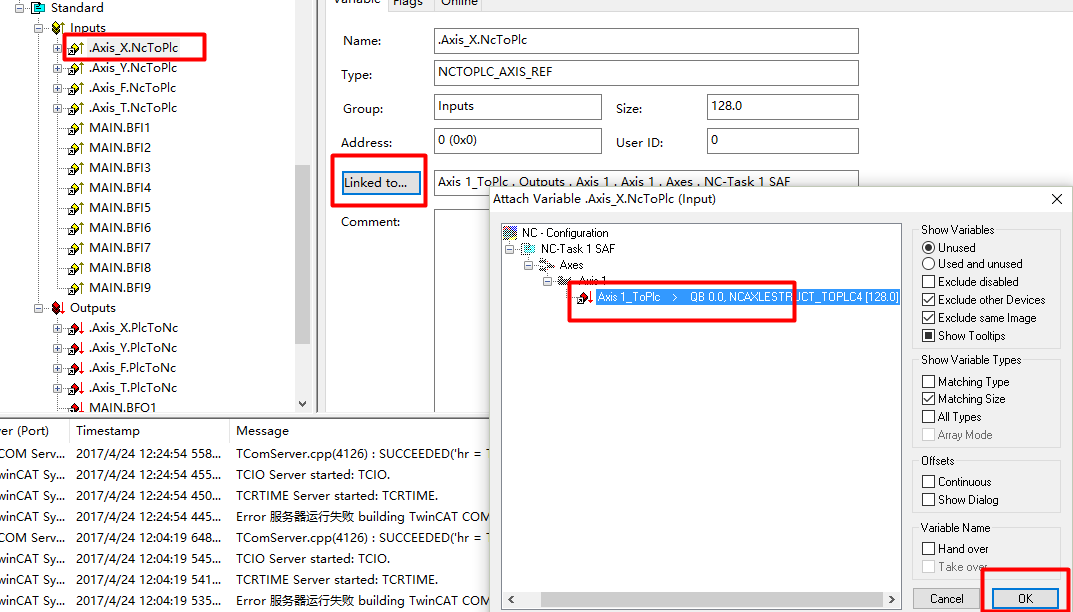
[picture p40: figure]

      8. 注册、保存
    v. PLC Control 设置
      1. 打开备份的PLC程序文件 X758PLC.pro

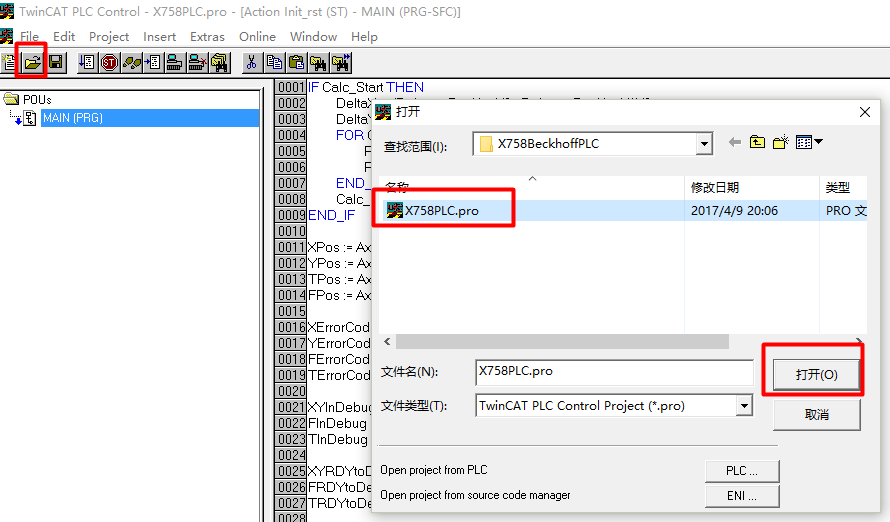
[picture p41: figure]

      2. 下载进控制器
        a) Online – Login – Run
        b) Online – Login – Sourcecode download
        c) Online – Login – Create Bootobject
      3. 保存
3. PLC调试
  a) 对照IO
    i. 打开项目资料文档：X758资料.xlsx
    ii. IO选项卡
    iii. 打开PLC调试软件
    iv. 停止PLC
    v. 对照IO表，依次检查PLC 输入/输出信号是否正确

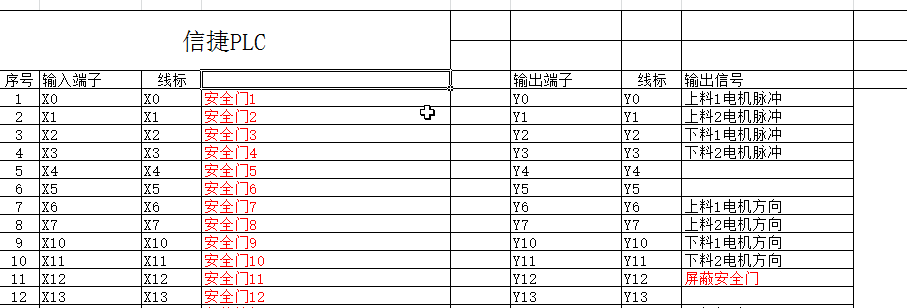
[picture p42: figure]

  b) 点动步进电机
    i. 运行PLC
    ii. 松开急停、屏蔽安全门
    iii. 手动置位步进调试流程
      2. S100调试1：上料步进调试
      3. S102调试2：下料步进调试

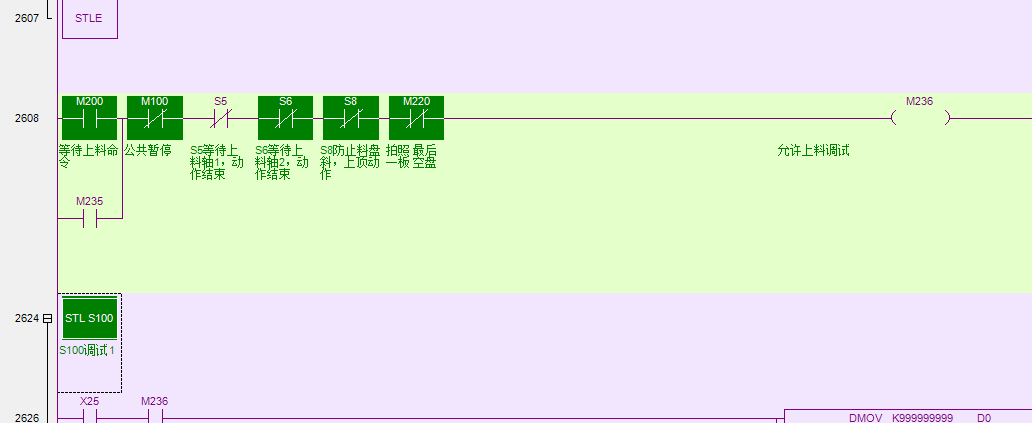
[picture p43: figure]

      5. 手动置ON条件
      6. 按对应上下按钮，执行电机升降
4. 机械手调试
  a) 机械手机械装配角度还原
    i. 要求装配将机械手爪手固定件缺口与机械手Z轴下限位缺口对齐
    ii. 点动机械手运动到上料点处
    iii. 松开机械手爪手固定件，再次调整机械手爪手角度。完成后，将其固定。
  b) 对照IO

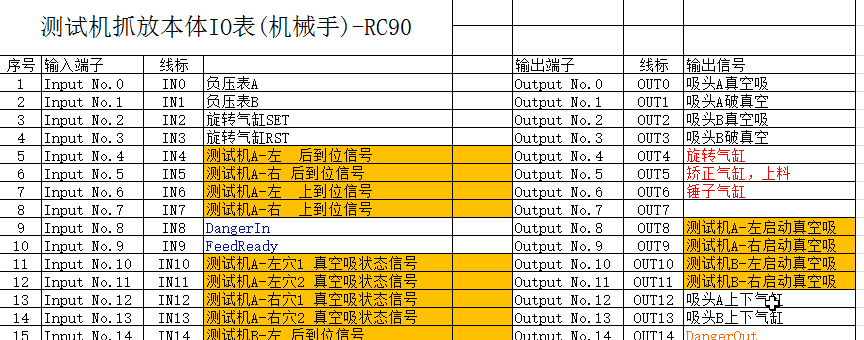
[picture p44: figure]
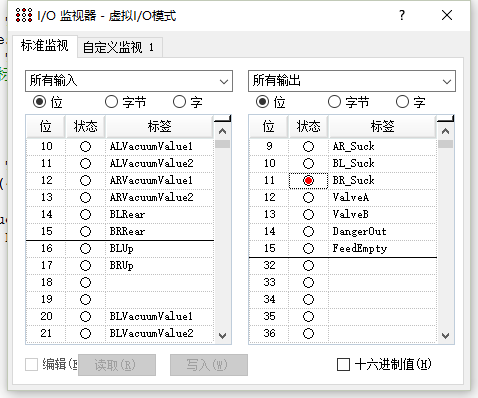
[picture p45: figure]

5. 轴控调试
  a) 打开上位机软体
  b) 登录- 轴控- 下料、底座、运输

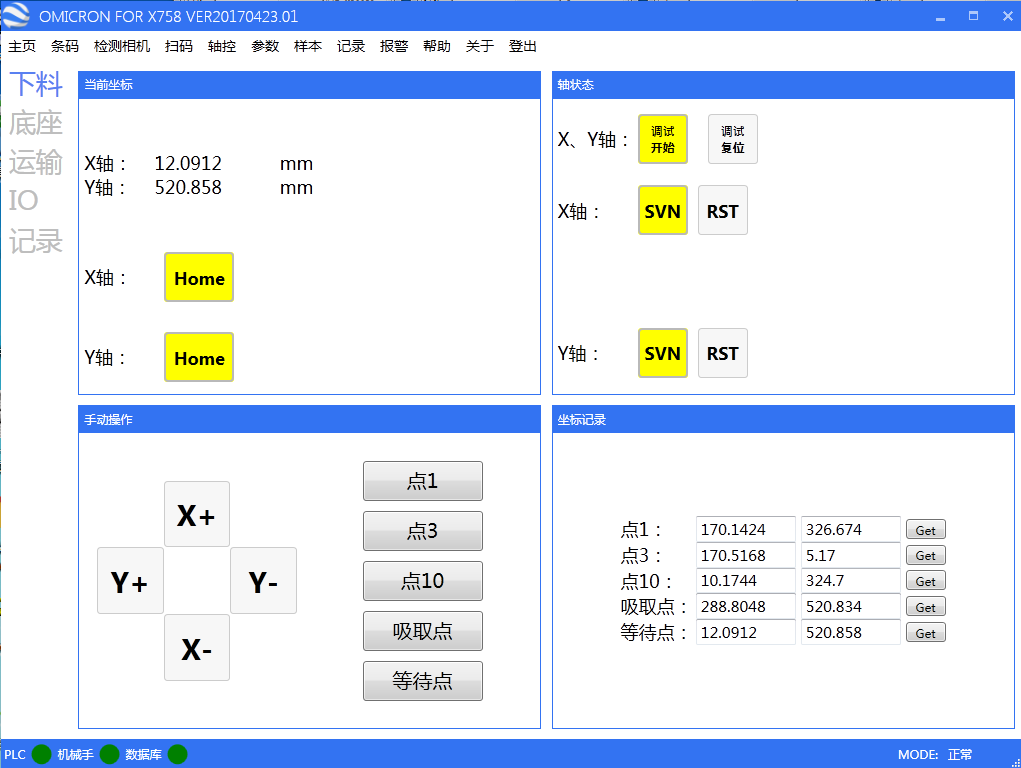
[picture p46: figure]

    i. 调试开始：切换轴控到调试模式
    ii. 调试复位：切换轴控到运行模式
    iii. Home：轴回原点操作
    iv. SVN：轴伺服励磁与释磁
    v. RST：轴报警复位
    vi. “+”和“-”：轴点动（JOG）运动
    vii. “点？”：轴运行到指定位置
    viii. “Get”：获得当前位置坐标到指定的点位寄存器
  d) 对照IO

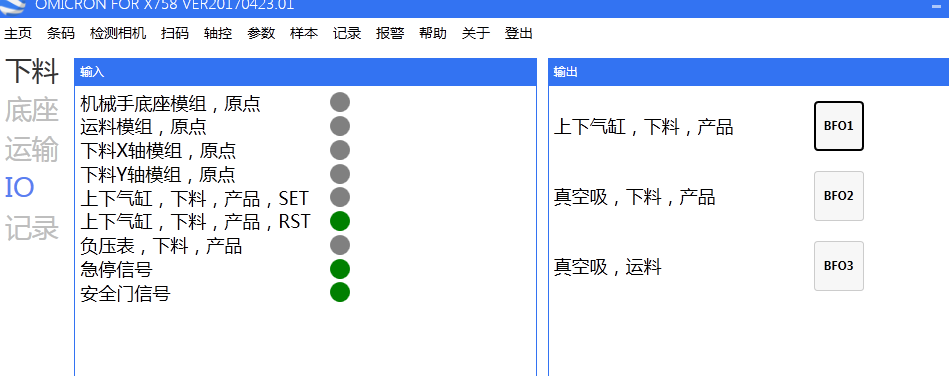
[picture p47: figure]
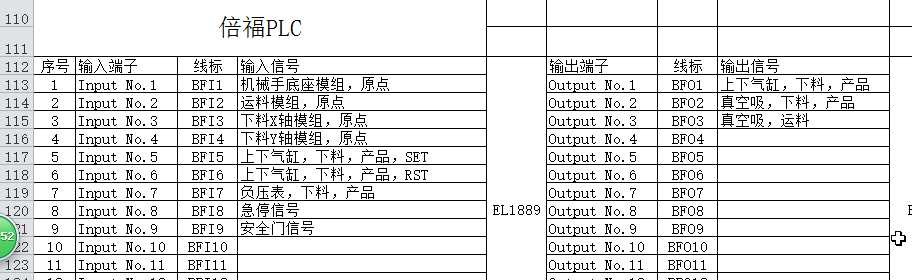
[picture p48: figure]

6. 相机调试
  a) 拷贝视觉脚本到相关目录
    i. 文件名称：检测相机脚本.hdev
  b) 打开上位机- 检测相机- 检测

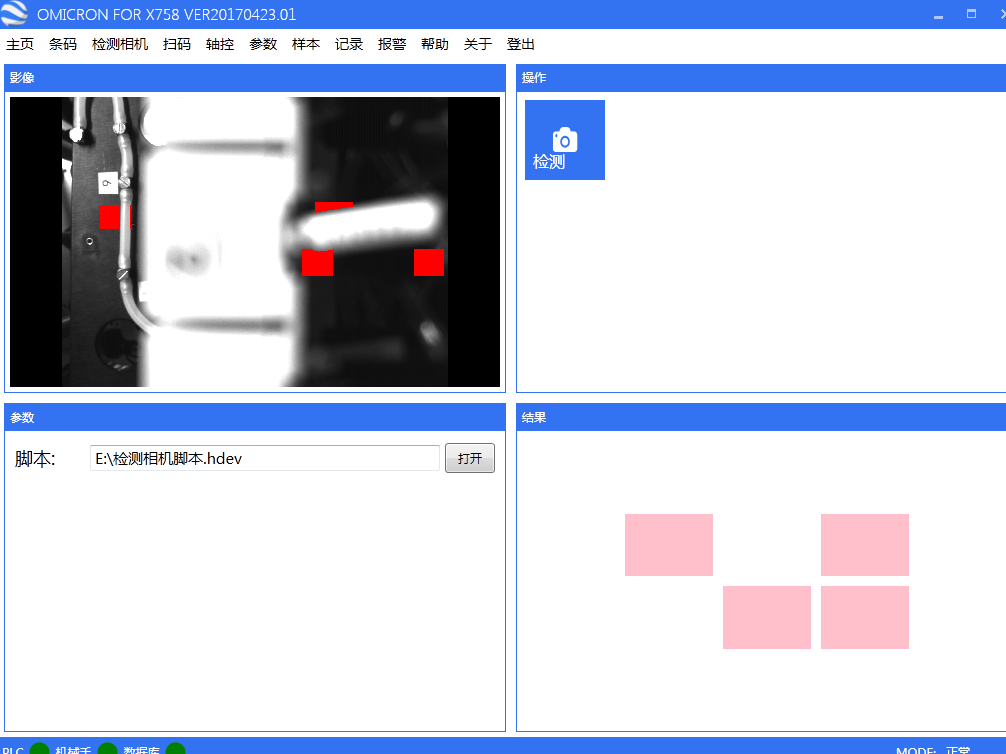
[picture p49: figure]

  d) 调整相机位置，使其拍摄的图像与要求的接近

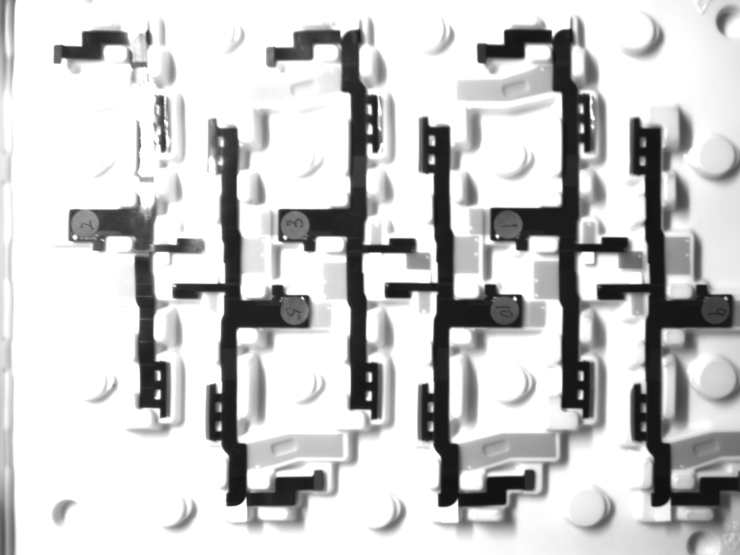
[picture p50: figure]

7. 试运行

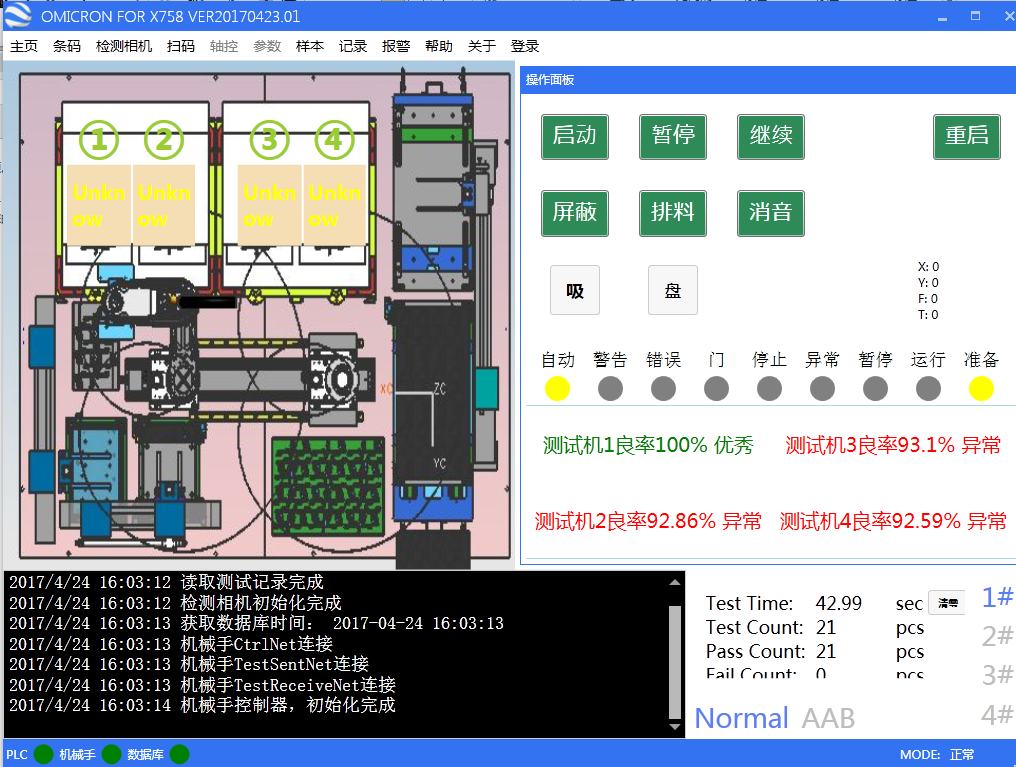
[picture p51: figure]
