LeaderXinjianSun/X758No2-PLC/(commit log)

2017-03-10 PLC整机程序初版设计完成，待验证
    [X758资料.xlsx]
2017-03-10 PLC轴 上下 运动 步 验证完成
2017-03-12 添加RC90
    [X758资料.xlsx]
2017-03-13 上料、下料调试完成
    [X758资料.xlsx]
2017-03-13 添加通信
    [X758资料.xlsx]
2017-03-15 添加触摸屏
    [X758资料.xlsx]
2017-03-19 修改触摸屏
    [X758资料.xlsx]
2017-03-19 更改最后一板空盘 处理
    [X758资料.xlsx]
2017-03-20 验证上料不需要再上一盘料
2017-03-21 取消Discharing信号影响
2017-03-23 添加上、下料盘个一个光纤
    [X758资料.xlsx]
2017-03-23 修改料单
    [X758资料.xlsx]
2017-03-25 改按钮控制电机上下
    [X758资料.xlsx]
2017-03-25 添加下料取料盘 判断真空延时
2017-03-26 更新IO 改PLC与机械手通信 成 硬件
    [X758资料.xlsx]
2017-03-27 添加电机参数
2017-04-02 上料添加光纤检测料盘斜
    [X758资料.xlsx]
2017-04-05 减少PLC上料时间
2017-04-13 相机提前拍照
    [X758资料.xlsx]
2017-04-14 修复最后一盘卡死bug
2017-04-19 添加上料盘与底座模组防呆
    [X758资料.xlsx]
2017-04-19 添加上料上下气缸复位传感器监控
2017-04-21 样本查询不良项目收集资料
    [G5Y7163B01SHP1953ZM5.csv, X758资料.xlsx]
2017-04-21 提前合爪、合2次；抛料断真空；吸取失败延时再吸取
    [X758资料.xlsx]
2017-04-23 样本查询不良项，验证完成
    [X758资料.xlsx]
2017-04-23 X758说明书初版设计完成
    [20174222031.csv, X758上料机使用说明附件.xlsx, X758资料.xlsx]
2017-04-23 添加说明书截图
    [01.dwg, 02.dwg, 03.dwg, 04.dwg, 05.dwg, 06.dwg, 07.dwg, 08.dwg]
2017-04-24 添加调试手册文档
    [X758上料机使用说明附件.xlsx]
2017-04-25 修改拍照置位气缸Y20不受排料信号影响
    [X758资料.xlsx]
2017-04-27 1、判断上料盘是否有料，判断多pcs，节约时间。
    [X758资料.xlsx]
2017-04-27 无杆气缸离开1.5秒，触发拍照
    [X758资料.xlsx]
2017-04-28 1、上料盘取料，最后一片，吸盘提前拎起产品
    [X758资料.xlsx]
2017-04-28 改回气缸离开1.5秒，触发拍摄
2017-04-29 修复无杆气缸离开，拍照，气缸提前到达传感器，上升沿M270不置位
2017-05-03 添加治具先对位信号
    [X758资料.xlsx]
2017-05-05 提前拍照
    [X758资料.xlsx]
2017-05-06 RST Y20 添加传感器检测，防止碰撞
2017-05-08 更新图纸
    [01.dwg, 05.dwg, 06.dwg, 07.dwg, 11.dwg, 12.dwg, 13.dwg, 14.dwg]
2017-05-08 更新电路图、物料单
    [01.dwg, 02.dwg, 03.dwg, 05.dwg, 06.dwg, 07.dwg, 08.dwg, 09.dwg]
2017-05-17 修复提前拍照，空盘没放完就过来再取BUG
2017-05-19 添加等待拍摄完成，检测传感器，复位M505。
2017-05-19 继续修改，下料盘传感器位置，影响代码bug
2017-05-27 添加Mac os软件
    [X758项目交流表.xlsx, X758项目表格总汇.xlsx]
2017-06-05 更改上料动作
2017-06-05 添料，再拍摄
    [X758资料.xlsx]
2017-06-06 修改添料逻辑时间
2017-06-08 修复上料盘吸取失败不报警，不吹料，导致跌料问题
2017-06-10 内容：1、上料空盘吸取失败，按复位，关真空；2、下料盘，先下降再上升
2017-06-10 20170610备份1
2017-06-17 下料盘15片，自动下降
2017-06-22 下料盘下降5cm
2017-06-23 机械手暂停不再响
    [X758资料.xlsx]
2017-06-26 下料盘，后上升
2017-06-29 PLC 复位运行 仅需按一次复位按钮
2017-07-04 屏蔽后两个门
2017-07-08 下料盘改为10盘下降
2017-07-15 更换多芯线
    [19.dwg, X758资料.xlsx]
2017-07-16 添加Noise点位
    [X758资料.xlsx]
2017-07-20 上料，仅一个光纤感应到，超过0.5
2017-07-24 下料由10盘改为25盘
2017-07-25 报警延长至10s
    [X758资料.xlsx]
2017-08-01 上料空盘处，若无料盘，则先升上去
2017-08-12 上料盘漏料，除了显示，报警声需要响起来
2017-08-24 添加技术手册封面
    [01.dwg, X758资料.xlsx]
2017-08-24 更改报警指示灯逻辑
    [X758资料.xlsx]
2017-08-25 下料盘提前吸料
    [X758资料.xlsx]
2017-08-26 修复下料盘重复取盘BUG
2017-08-30 修复第8片料卡死问题
2017-09-08 修复下料吸取失败，报警不处理叠料bug
2017-09-10 人为按下上料盘，也计数
2017-09-11 添加无杆气缸计时
2017-09-16 更改无杆气缸点位
2017-09-24 触摸屏对应更改无杆气缸点位
2017-09-25 添加上下料极限传感器监控记录
    [X758资料.xlsx]
2017-09-29 添加安全门屏蔽自复位
2017-09-30 改坐标控制
2017-10-12 防止超极限
